talbo/Mendel90VAL/val/bom/bom.txt

Vitamins:
          E                                                         
          x                                                         
          t                                                         
          r                                                         
          u                                                         
          d                                                         
          e                                                         
          r                                                         
                                                                    
          c  E                          X                       Z   
          o  x                                                      
          n  t                 S        c                       l   
    E     n  r                 p        a                       i   
    l     e  u                 o     X  r           Y           m   
    e     c  d           P     o        r                       i   
    c  E  t  e           r     l     c  i           c           t   
 B  t  x  i  r     H  M  i           a  a  X  X     a  Y  Y        Z
 e  r  t  o        o  a  n     h  X  r  g        Y  r        Z  s   
 d  o  r  n  m  F  t  c  t     o     r  e  i  m     r  i  m     w  m
    n  u     o  r     h        l  a  i     d  o  a  i  d  o  a  i  o
 f  i  d  p  t  a  e  i  b  P  d  x  a  f  l  t  x  a  l  t  x  t  t
 a  c  e  c  o  m  n  n  e  s  e  i  g  a  e  o  i  g  e  o  i  c  o
 n  s  r  b  r  e  d  e  d  u  r  s  e  n  r  r  s  e  r  r  s  h  r
  |  |  |  |  | 2|  |  |  |  |  |  |  |  |  |  |  |  |  |  |  |  |  |  2 Acrylic sheet 158mm x 386mm x 5mm
  |  |  |  |  |  |  |  |  |  |  |  |  |  |  |  |  | 1|  |  |  |  |  |  1 Acrylic sheet 216mm x 216mm x 5mm
  |  |  |  |  | 1|  |  |  |  |  |  |  |  |  |  |  |  |  |  |  |  |  |  1 Acrylic sheet 471mm x 386mm x 5mm
  |  |  |  |  | 1|  |  |  |  |  |  |  |  |  |  |  |  |  |  |  |  |  |  1 Acrylic sheet 471mm x 419mm x 5mm
  |  |  |  |  |  |  |  |  | 1|  |  |  |  |  |  |  |  |  |  |  |  |  |  1 THS15 Aluminium clad resistor 10R
  |  |  |  |  |  |  |  |  | 1|  |  |  |  |  |  |  |  |  |  |  |  |  |  1 THS15 Aluminium clad resistor 4R7
  |  |  |  |  |  |  |  |  | 1|  |  |  |  |  |  |  |  |  |  |  |  |  |  1 PSU e.g. ALPINE500
  |  | 3|  |  |  |  |  |  |  | 4|  |  |  |  |  |  |  |  |  |  |  |  |  7 Ball bearing 608 8mm x 22mm x 7mm
  |  |  |  |  |  |  |  |  |  |  |  |  |  | 2|  |  |  | 2|  |  |  |  |  4 Ball bearing 624 4mm x 13mm x 5mm
  |  |  |  |  |  |  |  | 4|  |  |  |  |  |  |  |  |  |  |  |  |  |  |  4 19mm bulldog clip
  |  |  |  |  |  |  |  | 1|  |  |  |  |  |  |  |  |  |  |  |  |  |  |  1 PCB bed 214mm x 214mm
  |  |  |  |  |  |  |  |  |  |  |  |  |  |  |  | 1|  |  |  |  |  |  |  1 Belt T2 x 6mm x 662mm
  |  |  |  |  |  |  |  |  |  |  | 1|  |  |  |  |  |  |  |  |  |  |  |  1 Belt T2 x 6mm x 872mm
  |  |  |  |  |  |  |  | 4|  |  |  |  |  |  |  |  |  |  |  |  |  |  |  4 Corrugated cardboard 192mm x 216mm x 5mm
  |  |  |  |  |  |  |  | 4|  |  |  | 2|  |  |  |  |  |  |  |  |  |  |  6 M3 cap screw x 10mm
  | 4| 3|  |  |  |  |  |  |  |  |  |  |  |  | 6|  |14|  |  |  |  |  | 27 M3 cap screw x 16mm
  |  |  |  |  |  |  |  |  |  |  |  | 1|  |  | 2| 4| 2|  |  | 2|  |10| 21 M3 cap screw x 20mm
  |  |  |  |  |  |  |  |  |  |  |  | 2|  | 8| 8|  |  |  |  |  |  |  | 18 M3 cap screw x 25mm
  |  |  |  | 2|  |  |  |  |  |  |  |  |  |  | 1|  |  |  |  |  |  |  |  3 M3 cap screw x 45mm
  |  |  |  |  |34|  |  |  | 3| 2|  |  |  |  |  | 8|  | 1| 4| 4| 2| 4| 62 M4 cap screw x 16mm
 4|  |  |  |  |  |  |  |  |  |  |  |  |  |  |  |  |  |  |  |  |  |  |  4 M4 cap screw x 20mm
  |  |  |  |  |  |  |  |  |  |  |  |  | 4|  |  |  |  | 1|  |  |  |  |  5 M4 cap screw x 30mm
  |  |  |  |  |  |  |  |  |  |  |  |  |  | 1|  |  |  |  |  |  |  |  |  1 M4 cap screw x 45mm
  |  |  | 1|  |  |  |  |  |  |  |  |  |  |  |  |  |  |  |  |  |  |  |  1 15 way D PCB mount plug
  |  |  |  |  |  |  |  |  |  |  |  |  |  |  | 1|  |  |  |  |  |  |  |  1 15 way D IDC socket
  |  |  |  |  |  |  |  |  |  |  |  |  | 1|  |  |  |  |  |  |  |  |  |  1 Fan 60mm x 15mm
  |  |  |  |  |  |  |  |  |  | 1|  |  |  |  |  |  |  |  |  |  |  |  |  1 Foam sponge 20mm x 20mm x 20mm
  |  |  |  | 1|  |  |  |  |  |  |  |  |  |  | 1|  |  |  | 1|  |  |  |  3 M3 grub screw x 6mm
  |  |  |  |  |  |  |  | 1|  |  |  |  |  |  |  |  |  |  |  |  |  |  |  1 Glass sheet 214mm x 202mm x 2mm
  |  |  |  |  |  | 1|  |  |  |  |  |  |  |  |  |  |  |  |  |  |  |  |  1 JHead MK5 hot end
  |  |  |  |  |  |  |  | 4|  |  |  |  |  |  |  |  |  |  |  |  |  |  |  4 Hex male / female pillar M3 x 20mm
  |  | 3|  |  |  |  |  |  |  |  |  |  |  |  |  |  |  |  |  |  |  |  |  3 M3 hex screw x 10mm
  |  |  |  |  |  |  |  |  |  |  |  |  |  |  |  |  |  |  |  |  | 1|  |  1 M3 hex screw x 16mm
  |  | 2|  |  |  |  |  |  |  |  |  |  |  |  |  |  |  |  |  |  |  |  |  2 M4 hex screw x 20mm
  |  | 2|  |  |  |  |  |  |  |  |  |  |  |  |  |  |  |  |  |  |  |  |  2 M4 hex screw x 50mm
  |  | 1|  |  |  |  |  |  |  |  |  |  |  |  |  |  |  |  |  |  |  |  |  1 M8 hex screw x 60mm, hobbed at 25
  |  |  |  |  |  |  |  |  | 1|  |  |  |  |  |  |  |  |  |  |  |  |  |  1 IEC mains lead
  |  |  |  |  |  |  |  |  |  |  |  | 3|  | 2| 2|  | 3|  |  |  |  |  | 10 LM12UU linear bearing
  | 1|  |  |  |  |  |  |  |  |  |  |  |  |  |  |  |  |  |  |  |  |  |  1 Melzi electronics
  |  |  | 1|  |  |  |  |  |  |  |  |  |  |  |  |  |  |  |  |  |  |  |  1 2 way Molex KK header
  |  |  | 1|  |  |  |  |  |  |  |  |  |  |  |  |  |  |  |  |  |  |  |  1 3 way Molex KK header
  |  |  |  | 1|  |  |  |  |  |  |  |  |  |  | 1|  |  |  | 1|  |  | 2|  5 NEMA17 x 47mm stepper motor
  |  |  |  |  |  |  |  |  |  |  |  |  |  |  |  |  |  |  |  | 2|  |  |  2 Brass nut M6
  |  | 3|  | 3|  |  |  |  |  |  |  | 1|  |  |  |  |  |  |  |  |  |  |  7 Nut M3
  |  | 2|  |  |  |  |  |  |  |  |  |  |  |  |  |  |  |  |  |  |  |  |  2 Nut M4
  |  | 2|  |  |  |  |  |  |  |  |  |  |  |  |  |  |  |  |  |  |  |  |  2 Nut M8
  |  |  |  |  |  |  |  |  | 4|  |  |  |  |  |  |  |  |  |  |  |  |  |  4 Nyloc nut M2.5
  | 4|  |  |  |  |  |  |  |  |  |  | 4|  | 8|14| 4|16|  |  | 2| 1|10| 63 Nyloc nut M3
 4|  |  |  |  |36|  |  |  | 3| 2|  |  | 4| 1|  | 8|  | 2| 4| 4| 2| 4| 74 Nyloc nut M4
  |  |  |  |  |  |  |  |  |  |  |  |  |  |  | 2|  |  |  |  |  |  |  |  2 Nitrile O-ring 2.5mm x 1.6mm
  |  |  | 1|  |  |  |  |  |  |  |  |  |  |  |  |  |  |  |  |  |  |  |  1 Extruder connection PCB
  |  |  |  |  |  |  |  |  |  | 1|  |  |  |  |  |  |  |  |  |  |  |  |  1 PLA sample 3mm ~50m
  |  |  |  |  |  |  |  |  |  |  |  |  |  |  | 1|  |  |  |  |  |  |  |  1 Polypropylene strip 396mm x 18mm x 0.5mm
  |  |  |  |  |  |  |  |  |  |  |  |  |  |  | 1|  |  |  |  |  |  |  |  1 Polypropylene strip 494mm x 25mm x 0.5mm
  |  |  |  |  |  |  |  | 1|  |  |  |  |  |  |  |  |  |  |  |  |  |  |  1 Polypropylene strip 271mm x 33mm x 0.5mm
  |  |  |  |  |  |  |  |  | 4|  |  |  |  |  |  |  |  |  |  |  |  |  |  4 M2.5 pan screw x 12mm
  |  |  |  |  |  |  |  |  |  |  |  |  |  |  | 2|  |  |  | 4|  |  | 8| 14 M3 pan screw x 8mm
  |  |  |  |  |  |  |  |  | 2|  |  |  |  |  |  |  |  |  |  |  |  |  |  2 6-32 pan screw x 9.5mm
  |  |  |  | 2|  |  |  |  |  |  |  |  |  |  | 4| 2|  |  |  | 2| 2|  | 12 No2 pan wood screw x 13mm
  |  |  |  |  |  |  |  |  |  |  |  |  |  |  | 1|  |  |  | 1|  |  |  |  2 GT2 pulley 20 teeth
  |  |  |  |  |  |  |  |  |  |  |  |  |  |  | 1|  |  |  |  |  |  |  |  1 Ribbon cable 20 way 1260mm
  |  |  |  |  |  |  |  | 1|  |  |  |  |  |  |  |  |  |  |  |  |  |  |  1 Ribbon cable 26 way 381mm
  |  |  |  |  |  |  |  |  |  |  |  |  |  |  |  | 1|  |  |  |  |  |  |  1 Smooth rod 12mm x 276mm
  |  |  |  |  |  |  |  |  |  |  |  |  |  |  |  |  |  |  |  | 2|  |  |  2 Smooth rod 12mm x 338mm
  |  |  |  |  |  |  |  |  |  |  | 2|  |  |  |  |  |  |  |  |  |  |  |  2 Smooth rod 12mm x 387mm
  |  |  |  |  |  |  |  |  |  |  |  |  |  |  |  | 1|  |  |  |  |  |  |  1 Smooth rod 12mm x 417mm
  |  | 1|  |  |  |  |  |  |  |  |  |  |  |  |  |  |  |  |  |  |  |  |  1 Smooth rod 8mm x 22mm
  | 1|  |  |  |  |  |  |  |  |  |  |  |  |  |  |  |  |  |  |  |  |  |  1 Micro SD card
  | 1|  |  |  |  |  |  |  |  |  |  |  |  |  |  |  |  |  |  |  |  |  |  1 Micro SD to USB adapter
  |  |  |  |  |  |  |  |  |  |  |  |  |  |  | 1| 1|  |  |  | 1| 1|  |  4 Microswitch
  |  | 2|  |  |  |  |  |  |  |  |  |  |  |  |  |  |  |  |  |  |  |  |  2 Spring 7mm OD, 1mm gauge x 10mm long
  |  |  |  |  | 2|  |  |  |  |  |  |  |  |  |  |  |  |  |  |  |  |  |  2 AL square tube 12.7 x 12.7 x 1.63 x 400mm
  |  |  |  |  |  | 1|  |  |  |  |  |  |  |  |  |  |  |  |  |  |  |  |  1 110mm x 25mm self amalgamating silicone tape
  |  |  |  |  |  |  |  |  |  |  |  |  |  |  |  |  |  |  |  | 2|  |  |  2 Threaded rod M6 x 298mm
  |  |  |  |  |  |  |  |  | 1|  |  |  |  |  |  |  |  |  |  |  |  |  |  1 Heatshrink sleeving ID 10mm x 15mm
  |  |  |  |  |  | 2|  |  |  |  |  |  |  |  |  |  |  |  |  |  |  |  |  2 PTFE sleeving OD 1.2mm ID 0.71mm x 62mm
  |  |  |  |  |  | 2|  | 2|  |  |  |  |  |  |  |  |  |  |  |  |  |  |  4 Heatshrink sleeving ID 1.6mm x 15mm
  |  |  |  |  |  | 2|  |  |  |  |  |  |  |  |  |  |  |  |  |  |  |  |  2 PTFE sleeving OD 2.6mm ID 2mm x 45mm
  | 2|  |  |  |  |  |  | 2| 3|  |  |  |  |  | 4|  |  |  |  |  |  |  | 11 Heatshrink sleeving ID 2.4mm x 15mm
  |  |  |  |  |  |  |  |  | 5|  |  |  |  |  |  |  |  |  |  |  |  |  |  5 Heatshrink sleeving ID 3.2mm x 15mm
  |  |  |  |  |  |  |  |  |  | 1|  |  |  |  |  |  |  |  |  |  |  |  |  1 PTFE tubing OD 4.6mm ID 3.84mm x 750mm
  |  |  |  |  |  |  |  |  | 2|  |  |  |  |  |  |  |  |  |  |  |  |  |  2 Heatshrink sleeving ID 6.4mm x 15mm
  |  |  |  |  |  |  |  | 2|  |  |  |  |  |  |  |  |  |  |  |  |  |  |  2 Heatshrink sleeving ID 6.4mm x 30mm
  |  |  |  |  |  | 1|  |  |  |  |  |  |  |  |  |  |  |  |  |  |  |  |  1 Heatshrink sleeving ID 6.4mm x 60mm
  |  |  |  |  |  |  |  |  |  |  |  |  |  |  |  |  |  |  |  |  |  | 2|  2 Neoprene tubing OD 8mm ID 5mm x 16mm
  |  |  | 2|  |  |  |  |  |  |  |  |  |  |  |  |  |  |  |  |  |  |  |  2 4 way terminal block
  |  |  |  |  |  |  |  | 1|  |  |  |  |  |  |  |  |  |  |  |  |  |  |  1 Epcos B57861S104F40 100K 1% thermistor
  | 1|  |  |  |  |  |  |  |  |  |  |  |  |  |  |  |  |  |  |  |  |  |  1 USB A to Mini B lead
  |  |  |  | 2|  |  |  |  | 4|  |  |  |  |  | 4| 2|  |  |  | 2| 2|  | 16 Washer M2.5 x 5.9mm x 0.5mm
  | 8| 3|  | 2|  |  |  | 4|  |  |  | 4|  | 8|21| 4|16|  | 4| 2| 1|18| 95 Washer M3 x 7mm x 0.5mm
 4|  | 7|  |  |38|  |  |  | 5| 2|  |  | 4| 2|  | 8|  | 5| 4| 4| 2| 4| 89 Washer M4 x 9mm x 0.8mm
  |  |  |  |  |  |  |  |  |  |  |  |  |  | 2|  |  |  | 2|  |  |  |  |  4 Washer M5 x 20mm x 1.4mm
  |  |  |  |  |  |  |  |  |  |12|  |  |  |  |  |  |  |  |  |  |  |  | 12 Washer M8 x 17mm x 1.6mm
  |  |  |  |  |  |  |  |  |  | 4|  |  |  |  |  |  |  |  |  |  |  |  |  4 Washer M8 x 30mm x 1.5mm
  |  |  |  |  |  |  |  |  |  |  | 2|  |  |  |  |  |  |  |  |  |  |  |  2 Wingnut M4
  |  |  |  |  |  | 2|  |  |  |  |  |  |  |  |  |  |  |  |  |  |  |  |  2 Red PTFE wire 16/0.2 length 170mm
  |  |  |  |  |  |  |  |  |  |  |  |  |  |  |  |  |  |  |  |  | 2|  |  2 Rubber washer M3 x 10mm x 1.5mm
  |  |  |  |  |  |  |  | 1|  |  |  |  |  |  |  |  |  |  |  |  |  |  |  1 Black wire 32/0.2 length 635mm
  |  |  |  |  |  |  |  | 1|  |  |  |  |  |  |  |  |  |  |  |  |  |  |  1 Red wire 32/0.2 length 620mm
  |  | 6|  |  |  |  |  |  |  |  |  |  |  |  | 2|  |  |  | 4|  |  | 8| 20 Star washer M3 x 0.5mm
  |  |  |  |  |  |  |  |  | 2|  |  |  |  |  |  |  |  |  |  |  |  |  |  2 Star washer M4 x 0.8mm
  |  | 1|  |  |  |  |  |  |  |  |  |  |  |  |  |  |  |  |  |  |  |  |  1 Star washer M8 x 1.6mm
  |  |  |  |  |10| 1|  |  | 2|  |  |  |  |  |  |  |  |  |  |  |  |  | 13 Ziptie 100mm min length
  |  |  |  |  |  |  |  |  |  |  |  | 3|  |  |  |  | 3|  |  |  |  |  |  6 Ziptie 111mm min length

Printed:
  |  |  |  |  |  |  |  |  | 1|  |  |  |  |  |  |  |  |  |  |  |  |  |  1 atx_long_bracket.stl
  |  |  |  |  |  |  |  |  | 1|  |  |  |  |  |  |  |  |  |  |  |  |  |  1 atx_short_bracket.stl
  |  |  |  | 1|  |  |  |  |  |  |  |  |  |  |  |  |  |  |  |  |  |  |  1 d_motor_bracket.stl
  |  |  |  | 1|  |  |  |  |  |  |  |  |  |  |  |  |  |  |  |  |  |  |  1 d_motor_bracket_lid.stl
  |  |  |  |  |  |  |  |  |  |  |  |  |  |  | 1|  |  |  |  |  |  |  |  1 d_shell.stl
  |  |  |  |  |  |  |  |  |  |  |  |  |  |  | 1|  |  |  |  |  |  |  |  1 d_shell_lid.stl
  |  |  |  |  |  |  |  |  |  | 1|  |  |  |  |  |  |  |  |  |  |  |  |  1 dust_filter.stl
 1|  |  |  |  |  |  |  |  |  |  |  |  |  |  |  |  |  |  |  |  |  |  |  1 fan_guard.stl
  |  |  |  |  | 8|  |  |  |  |  |  |  |  |  |  |  |  |  |  |  |  |  |  8 fixing_block.stl
  | 4|  |  |  |  |  |  |  |  |  |  |  |  |  |  |  |  |  |  |  |  |  |  4 pcb_spacer.stl
  |  |  |  |  | 2|  |  |  |  |  |  |  |  |  |  |  |  |  |  |  |  |  |  2 rear_fixing_block.stl
  |  |  |  |  |  |  |  |  |  |  |  |  |  |  | 1|  |  |  |  |  |  |  |  1 ribbon_clamp_14_33.stl
  |  |  |  |  |  |  |  |  |  |  |  |  |  |  | 1|  |  |  |  |  |  |  |  1 ribbon_clamp_14_33NB.stl
  |  |  |  |  |  |  |  |  |  |  |  |  |  |  | 1|  |  |  |  |  |  |  |  1 ribbon_clamp_20_33.stl
  |  |  |  |  | 1|  |  |  |  |  |  |  |  |  |  |  |  |  |  |  |  |  |  1 ribbon_clamp_20_44N.stl
  |  |  |  |  |  |  |  |  |  |  |  |  |  |  |  |  | 1|  |  |  |  |  |  1 ribbon_clamp_26_33.stl
  |  |  |  |  |  |  |  |  |  |  |  |  |  |  |  |  | 1|  |  |  |  |  |  1 ribbon_clamp_26_33N.stl
  |  |  |  |  | 1|  |  |  |  |  |  |  |  |  |  |  |  |  |  |  |  |  |  1 ribbon_clamp_26_44N.stl
  |  |  |  |  |  |  |  |  |  | 2|  |  |  |  |  |  |  |  |  |  |  |  |  2 spool_bracket_female.stl
  |  |  |  |  |  |  |  |  |  | 2|  |  |  |  |  |  |  |  |  |  |  |  |  2 spool_bracket_male.stl
  |  |  |  |  | 4|  |  |  |  |  |  |  |  |  |  |  |  |  |  |  |  |  |  4 tube_cap.stl
  |  | 1|  |  |  |  |  |  |  |  |  |  |  |  |  |  |  |  |  |  |  |  |  1 wades_big_gear.stl
  |  | 1|  |  |  |  |  |  |  |  |  |  |  |  |  |  |  |  |  |  |  |  |  1 wades_block.stl
  |  | 1|  |  |  |  |  |  |  |  |  |  |  |  |  |  |  |  |  |  |  |  |  1 wades_gear_spacer.stl
  |  | 1|  |  |  |  |  |  |  |  |  |  |  |  |  |  |  |  |  |  |  |  |  1 wades_idler_block.stl
  |  |  |  | 1|  |  |  |  |  |  |  |  |  |  |  |  |  |  |  |  |  |  |  1 wades_small_gear.stl
  |  |  |  |  |  |  |  |  |  |  |  | 1|  |  |  |  |  |  |  |  |  |  |  1 x_belt_clamp.stl
  |  |  |  |  |  |  |  |  |  |  |  | 1|  |  |  |  |  |  |  |  |  |  |  1 x_belt_grip.stl
  |  |  |  |  |  |  |  |  |  |  |  | 1|  |  |  |  |  |  |  |  |  |  |  1 x_belt_tensioner.stl
  |  |  |  |  |  |  |  |  |  |  |  | 1|  |  |  |  |  |  |  |  |  |  |  1 x_carriage.stl
  |  |  |  |  |  |  |  |  |  |  |  |  | 1|  |  |  |  |  |  |  |  |  |  1 x_carriage_fan_bracket.stl
  |  |  |  |  |  |  |  |  |  |  |  |  | 1|  |  |  |  |  |  |  |  |  |  1 x_carriage_fan_duct.stl
  |  |  |  |  |  |  |  |  |  |  |  |  |  | 2| 2|  |  |  |  |  |  |  |  4 x_end_clamp.stl
  |  |  |  |  |  |  |  |  |  |  |  |  |  | 1|  |  |  |  |  |  |  |  |  1 x_idler_bracket.stl
  |  |  |  |  |  |  |  |  |  |  |  |  |  |  | 1|  |  |  |  |  |  |  |  1 x_motor_bracket.stl
  |  |  |  |  |  |  |  |  |  |  |  |  |  |  | 1|  |  |  |  |  |  |  |  1 x_motor_ribbon_bracket.stl
  |  |  |  |  |  |  |  |  |  |  |  |  |  |  |  | 3|  |  |  |  |  |  |  3 y_bar_clamp.stl
  |  |  |  |  |  |  |  |  |  |  |  |  |  |  |  | 1|  |  |  |  |  |  |  1 y_bar_clamp_switch.stl
  |  |  |  |  |  |  |  |  |  |  |  |  |  |  |  |  | 3|  |  |  |  |  |  3 y_bearing_mount.stl
  |  |  |  |  |  |  |  |  |  |  |  |  |  |  |  |  | 1|  |  |  |  |  |  1 y_belt_anchor.stl
  |  |  |  |  |  |  |  |  |  |  |  |  |  |  |  |  | 1|  |  |  |  |  |  1 y_belt_anchor_toothed.stl
  |  |  |  |  |  |  |  |  |  |  |  |  |  |  |  |  | 1|  |  |  |  |  |  1 y_belt_clip.stl
  |  |  |  |  |  |  |  |  |  |  |  |  |  |  |  |  | 1|  |  |  |  |  |  1 y_belt_clip_toothed.stl
  |  |  |  |  |  |  |  |  |  |  |  |  |  |  |  |  |  | 1|  |  |  |  |  1 y_idler_bracket.stl
  |  |  |  |  |  |  |  |  |  |  |  |  |  |  |  |  |  |  | 1|  |  |  |  1 y_motor_bracket.stl
  |  |  |  |  |  |  |  |  |  |  |  |  |  |  |  |  |  |  |  | 2|  |  |  2 z_bar_clamp.stl
  |  |  |  |  |  |  |  |  |  |  |  |  |  |  |  |  |  |  |  |  |  | 4|  4 z_coupling.stl
  |  |  |  |  |  |  |  |  |  |  |  |  |  |  |  |  |  |  |  |  | 1|  |  1 z_limit_switch_bracket.stl
  |  |  |  |  |  |  |  |  |  |  |  |  |  |  |  |  |  |  |  |  |  | 1|  1 z_motor_bracket_lhs.stl
  |  |  |  |  |  |  |  |  |  |  |  |  |  |  |  |  |  |  |  |  |  | 1|  1 z_motor_bracket_rhs.stl
  |  |  |  |  |  |  |  |  |  |  |  |  |  |  |  |  |  |  |  | 2|  |  |  2 z_screw_pointer.stl

Sub-assemblies:
  1 bed_fan_assembly
  1 electronics_assembly
  1 extruder_assembly
  1 extruder_connection_pcb_assembly
  1 extruder_motor_assembly
  1 frame_assembly
  1 hot_end_assembly
  1 machine_assembly
  1 print_bed_assembly
  1 psu_assembly
  1 spool_holder_assembly
  1 x_axis_assembly
  1 x_carriage_assembly
  1 x_carriage_fan_assembly
  1 x_idler_assembly
  1 x_motor_assembly
  1 y_axis_assembly
  1 y_carriage_assembly
  1 y_idler_assembly
  1 y_motor_assembly
  1 z_axis_assembly
  1 z_limit_switch_assembly
  2 z_motor_assemblies
