talbo/Mendel90VAL/val/sheets/frame_gantry.dxf

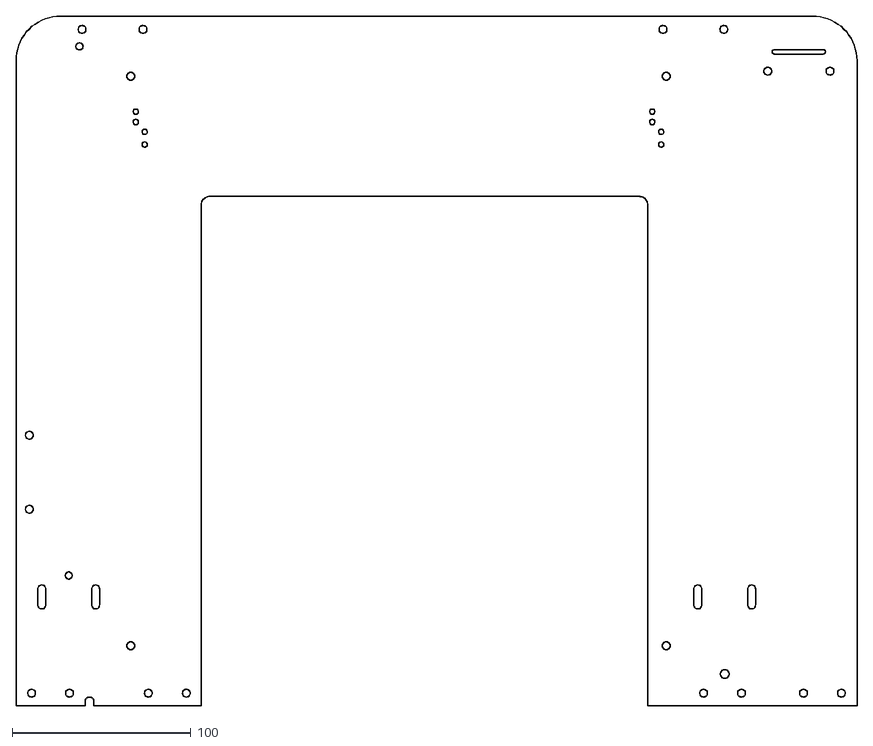
[picture p1: CAD file, 2014-06-18]
val/sheets/frame_gantry.dxf
470.5 x 386.0
