talbo/Mendel90VAL/val/stls/printed/x_motor_ribbon_bracket.stl

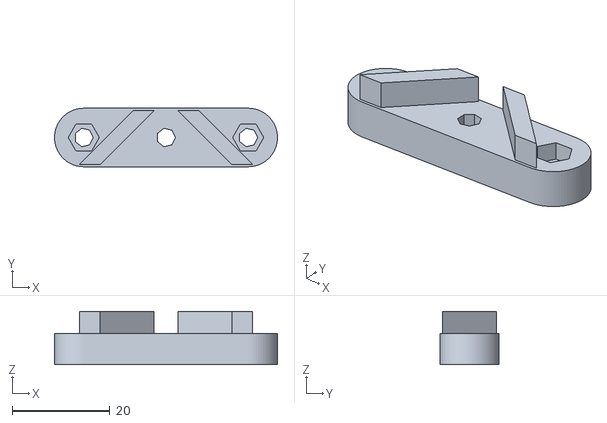
[picture p2: CAD file, 2014-06-18]
val/stls/printed/x_motor_ribbon_bracket.stl
45.7 x 12.0 x 10.9
