talbo/Mendel90VAL/val/stls/z_limit_switch_bracket.stl

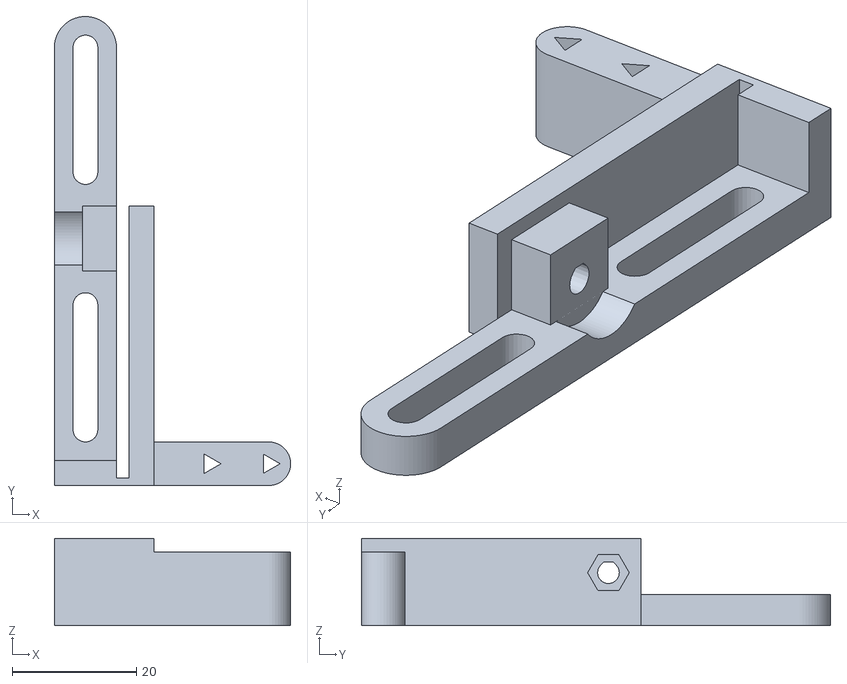
[picture p3: CAD file, 2014-06-18]
val/stls/z_limit_switch_bracket.stl
38.0 x 75.4 x 14.0
