talbo/Mendel90VAL/val/sheets/y_carriage.dxf

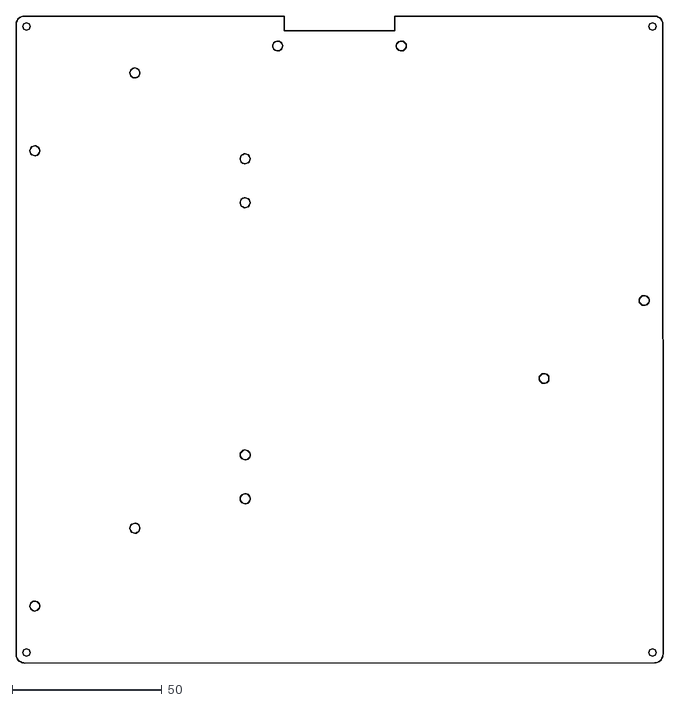
[picture p4: CAD file, 2014-06-18]
val/sheets/y_carriage.dxf
216.0 x 216.0
