talbo/Mendel90VAL/val/stls/printed/fan_guard.stl

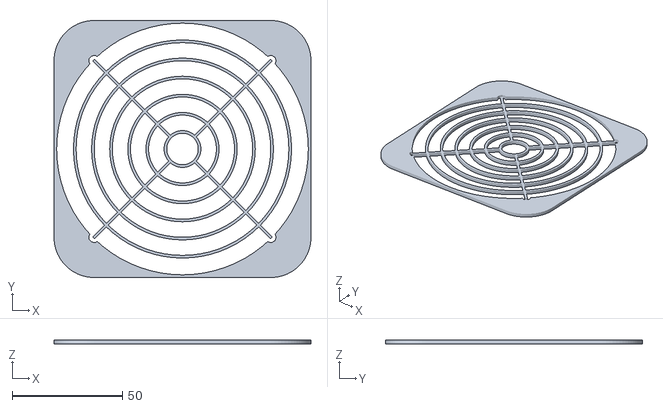
[picture p5: CAD file, 2014-06-18]
val/stls/printed/fan_guard.stl
116.4 x 116.4 x 2.00
