talbo/Mendel90VAL/val/stls/y_motor_bracket.stl

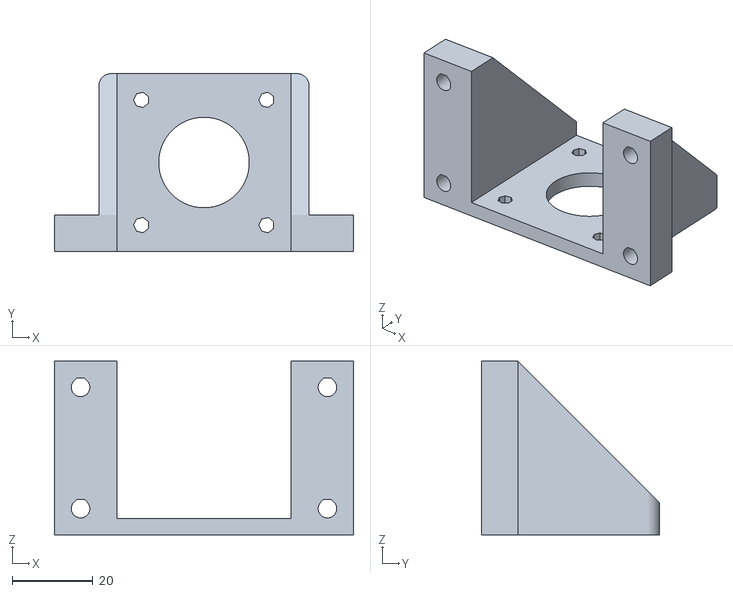
[picture p6: CAD file, 2014-06-18]
val/stls/y_motor_bracket.stl
74.0 x 44.0 x 43.0
