talbo/Mendel90VAL/val/sheets/frame_stays.dxf

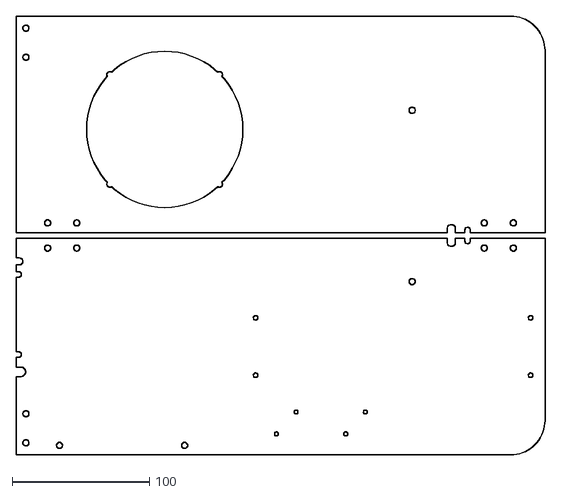
[picture p7: CAD file, 2014-06-18]
val/sheets/frame_stays.dxf
386.0 x 320.0
