talbo/Mendel90VAL/val/stls/printed/small_bits.stl

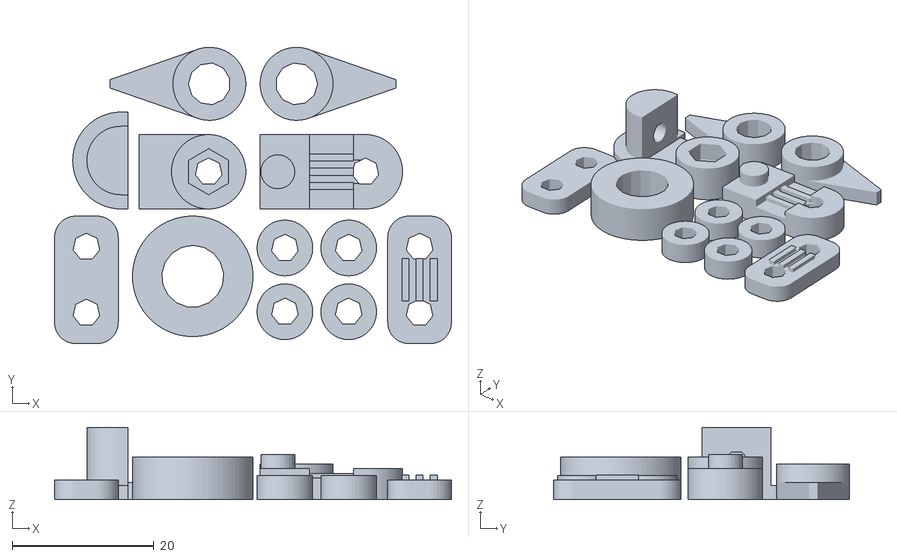
[picture p8: CAD file, 2014-06-18]
val/stls/printed/small_bits.stl
56.0 x 41.8 x 10.2
