talbo/Mendel90VAL/val/stls/z_motor_bracket_rhs.stl

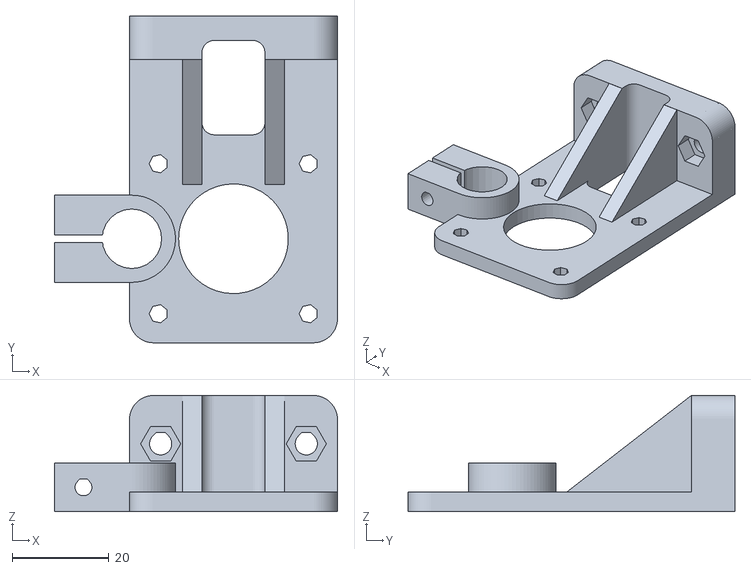
[picture p9: CAD file, 2014-06-18]
val/stls/z_motor_bracket_rhs.stl
58.5 x 67.5 x 24.0
