talbo/Mendel90VAL/val/sheets/frame_gantry_and_y_carriage.dxf

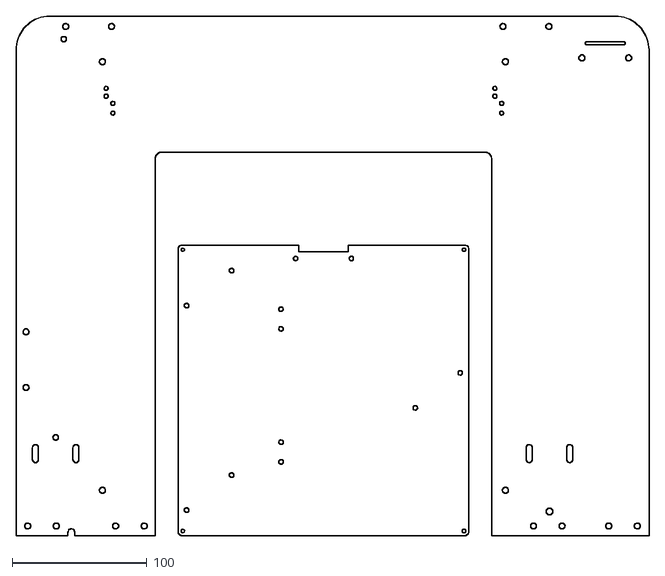
[picture p10: CAD file, 2014-06-18]
val/sheets/frame_gantry_and_y_carriage.dxf
470.5 x 386.0
