talbo/Mendel90VAL/val/stls/printed/z_motor_brackets.stl

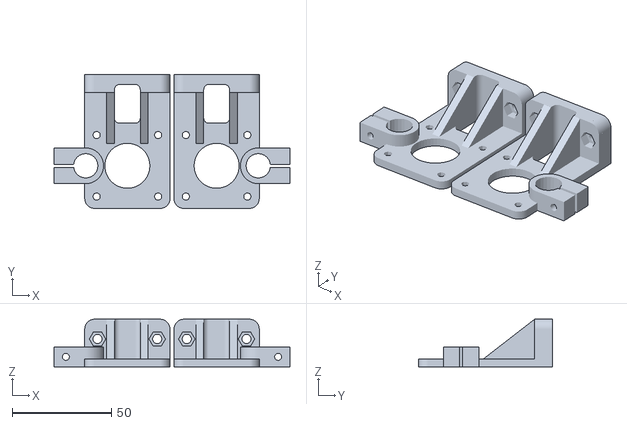
[picture p11: CAD file, 2014-06-18]
val/stls/printed/z_motor_brackets.stl
119.0 x 67.5 x 24.0
