talbo/Mendel90VAL/val/stls/tube_cap.stl

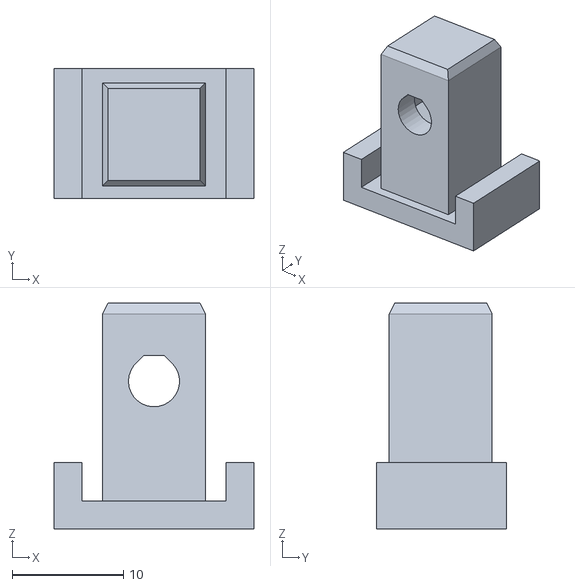
[picture p12: CAD file, 2014-06-18]
val/stls/tube_cap.stl
18.0 x 11.7 x 20.4
