talbo/Mendel90VAL/val/sheets/frame_base.dxf

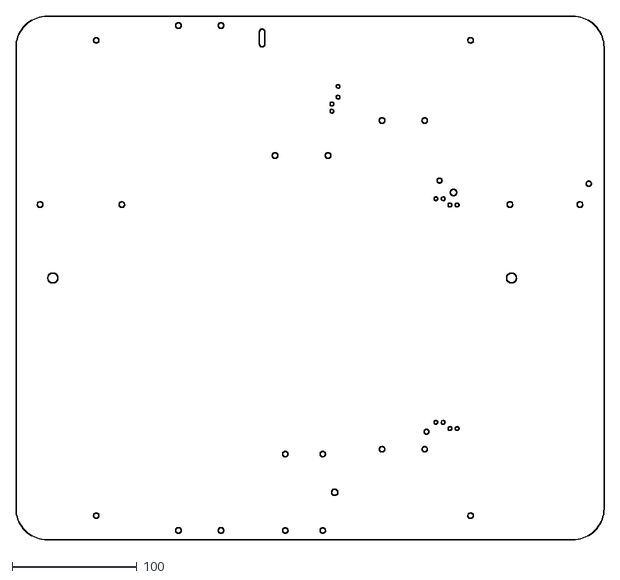
[picture p13: CAD file, 2014-06-18]
val/sheets/frame_base.dxf
470.5 x 419.0
