talbo/Mendel90VAL/val/stls/printed/wades_big_gear.stl

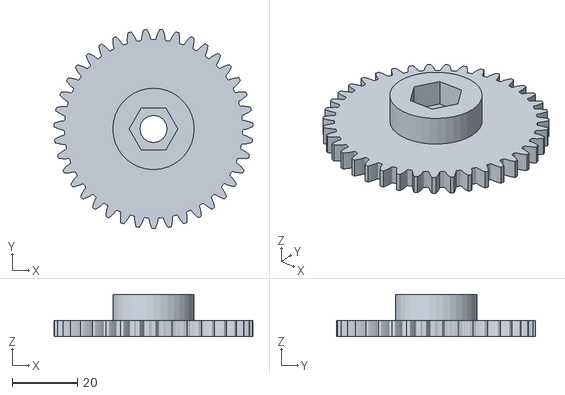
[picture p14: CAD file, 2014-06-18]
val/stls/printed/wades_big_gear.stl
61.1 x 61.1 x 13.0
