talbo/Mendel90VAL/val/stls/x_belt_grip.stl

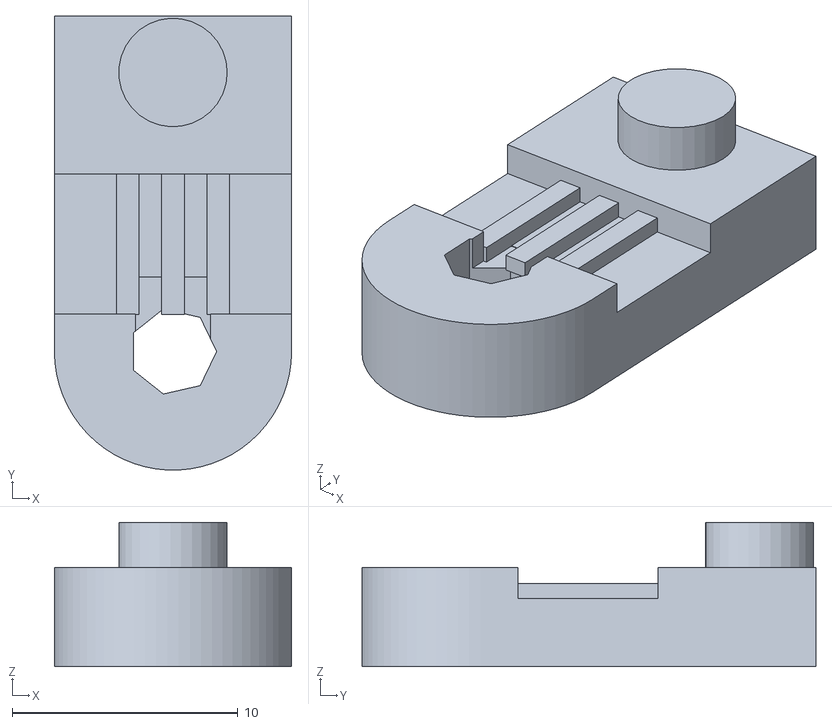
[picture p15: CAD file, 2014-06-18]
val/stls/x_belt_grip.stl
10.5 x 20.1 x 6.39
