talbo/Mendel90VAL/val/sheets/y_heatshield.dxf

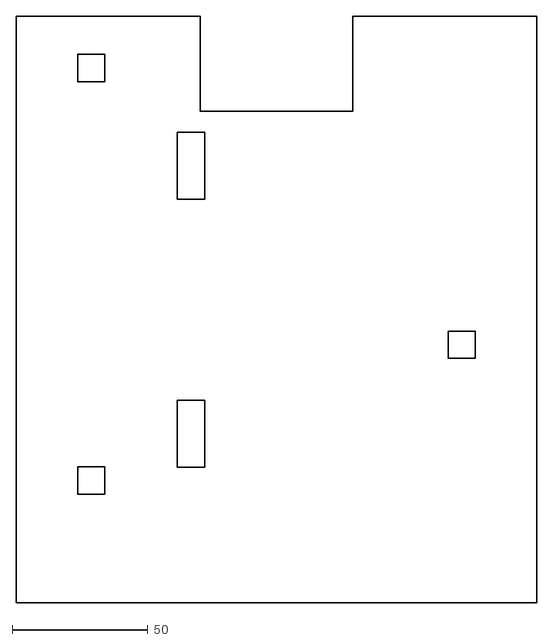
[picture p16: CAD file, 2014-06-18]
val/sheets/y_heatshield.dxf
192.0 x 216.0
