talbo/Mendel90VAL/val/stls/atx_short_bracket.stl

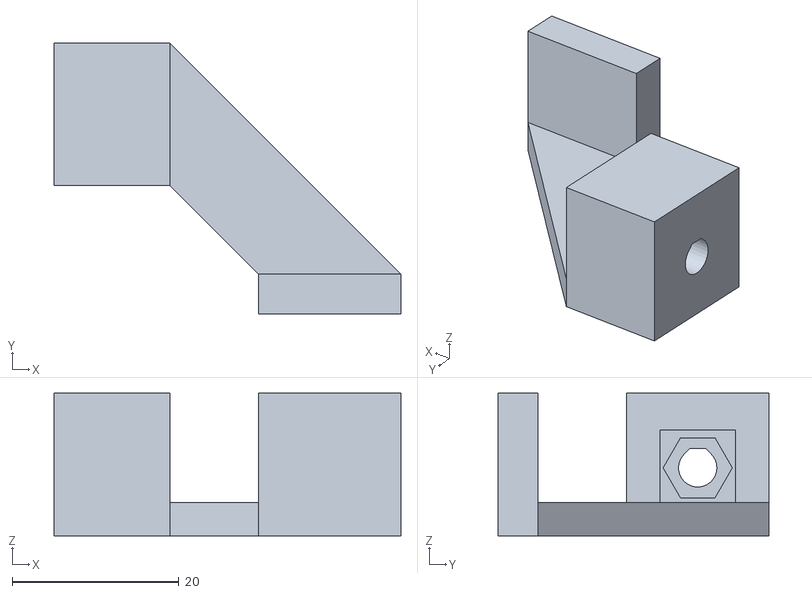
[picture p17: CAD file, 2014-06-18]
val/stls/atx_short_bracket.stl
41.6 x 32.5 x 17.1
