talbo/Mendel90VAL/val/sheets/frame_right.dxf

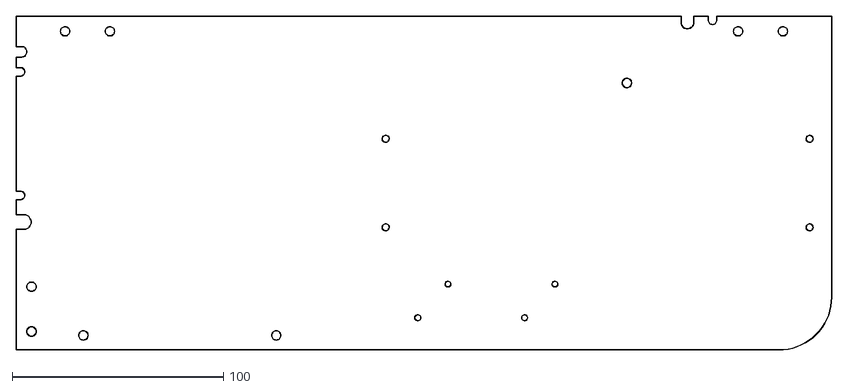
[picture p18: CAD file, 2014-06-18]
val/sheets/frame_right.dxf
386.0 x 158.0
