talbo/Mendel90VAL/val/stls/printed/x_carriage_parts.stl

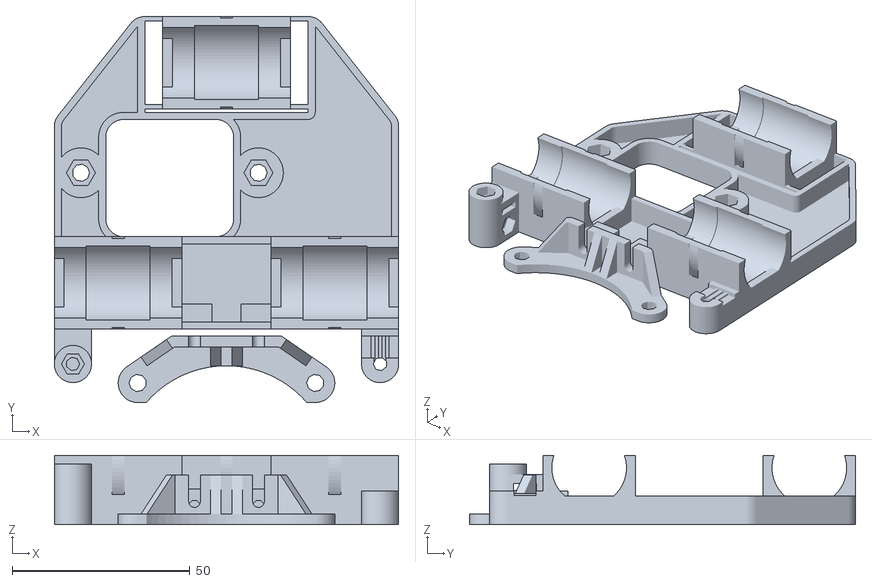
[picture p19: CAD file, 2014-06-18]
val/stls/printed/x_carriage_parts.stl
97.0 x 108.7 x 19.5
