talbo/Mendel90VAL/val/sheets/frame_left.dxf

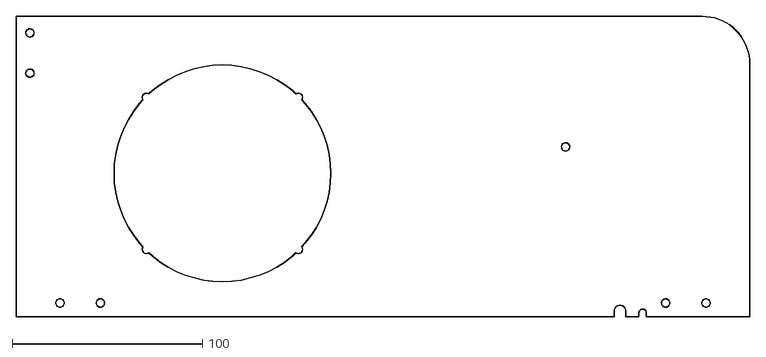
[picture p20: CAD file, 2014-06-18]
val/sheets/frame_left.dxf
386.0 x 158.0
