talbo/Mendel90VAL/val/stls/printed/x_end_clamp.stl

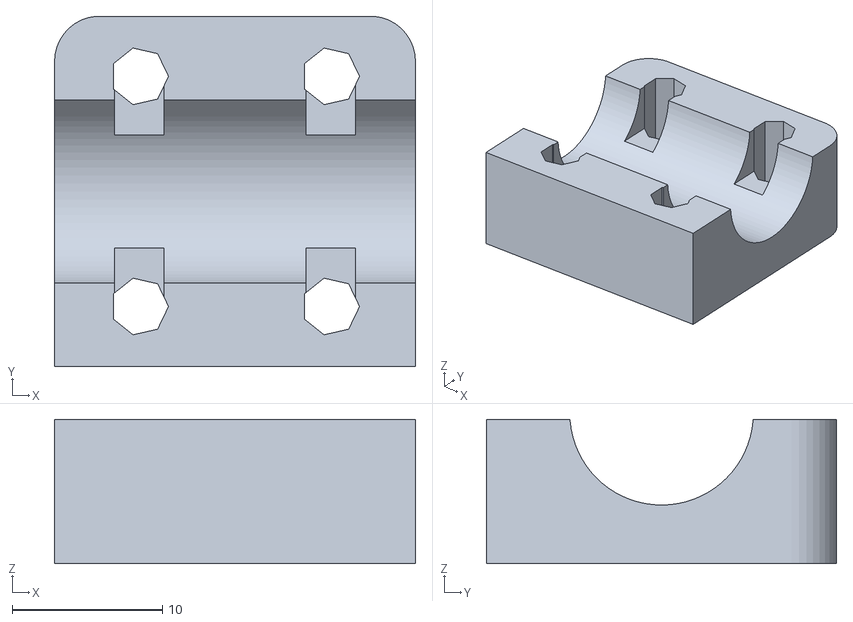
[picture p21: CAD file, 2014-06-18]
val/stls/printed/x_end_clamp.stl
24.0 x 23.3 x 9.60
