talbo/Mendel90VAL/val/stls/printed/y_idler_bracket.stl

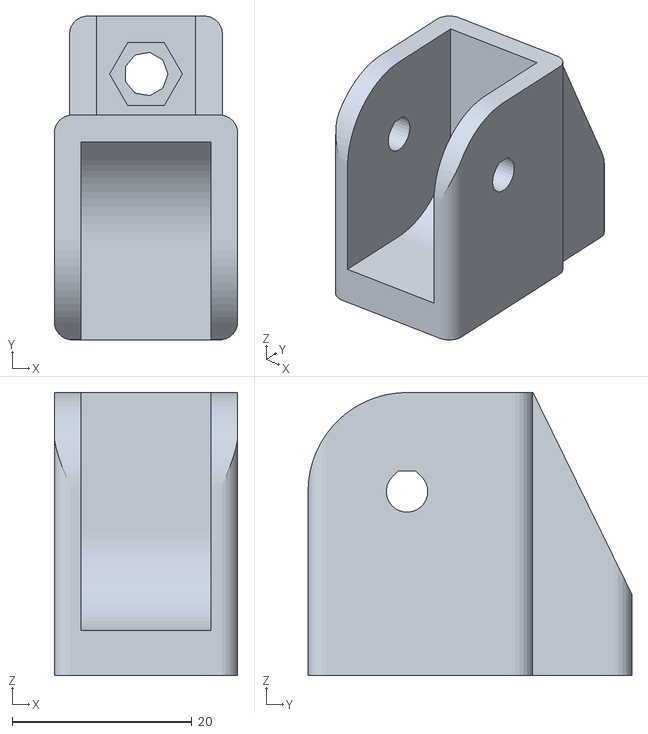
[picture p22: CAD file, 2014-06-18]
val/stls/printed/y_idler_bracket.stl
20.4 x 36.0 x 31.5
