talbo/Mendel90VAL/val/stls/spool_bracket_female.stl

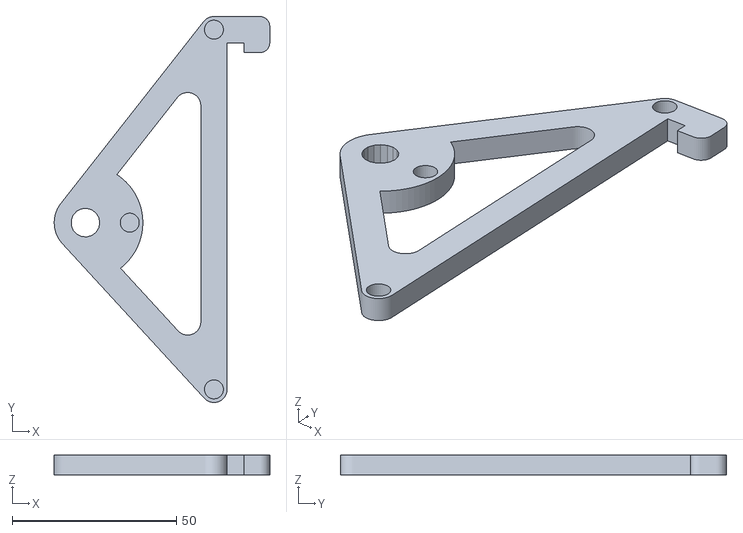
[picture p23: CAD file, 2014-06-18]
val/stls/spool_bracket_female.stl
65.6 x 117.5 x 6.00
