talbo/Mendel90VAL/val/stls/d_motor_bracket.stl

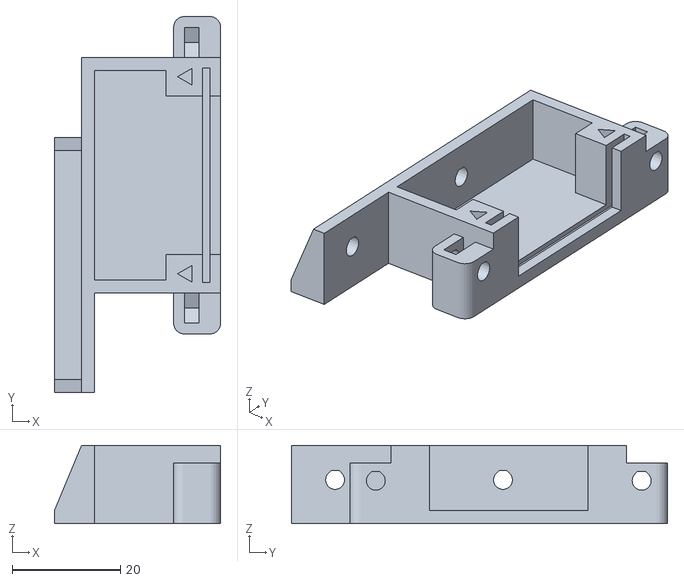
[picture p24: CAD file, 2014-06-18]
val/stls/d_motor_bracket.stl
30.7 x 69.4 x 14.4
