talbo/Mendel90VAL/val/stls/printed/d_motor_brackets.stl

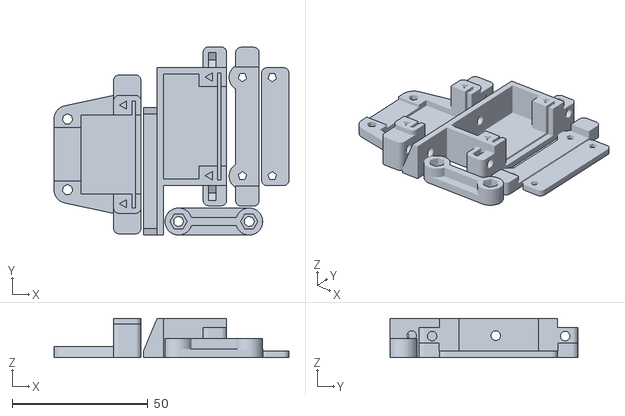
[picture p25: CAD file, 2014-06-18]
val/stls/printed/d_motor_brackets.stl
86.7 x 69.4 x 14.4
