talbo/Mendel90VAL/val/stls/printed/bar_clamps.stl

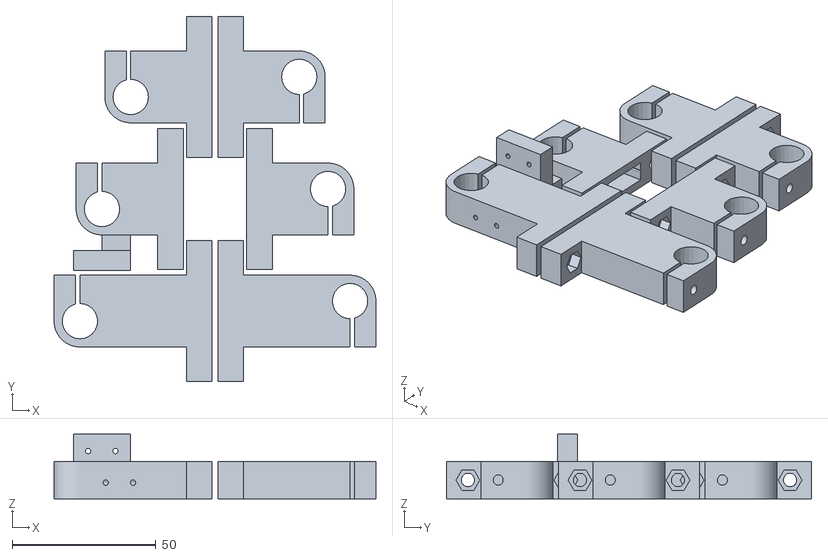
[picture p26: CAD file, 2014-06-18]
val/stls/printed/bar_clamps.stl
112.0 x 127.0 x 22.5
