talbo/Mendel90VAL/val/stls/spool_bracket_male.stl

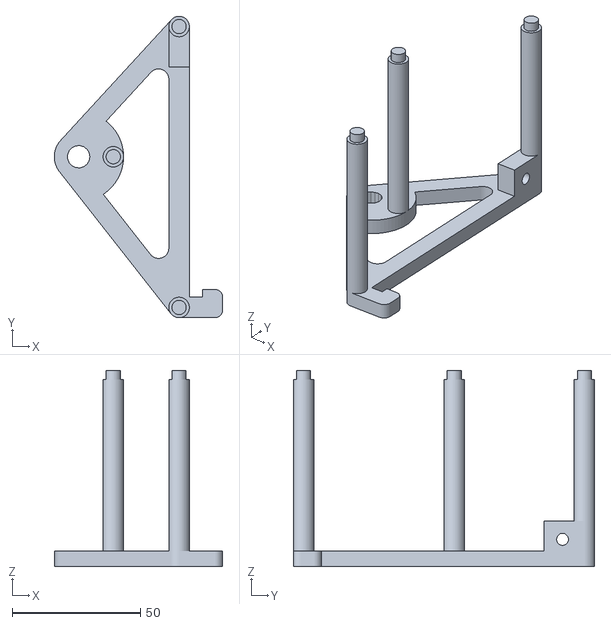
[picture p27: CAD file, 2014-06-18]
val/stls/spool_bracket_male.stl
65.6 x 117.5 x 76.4
