talbo/Mendel90VAL/val/stls/printed/y_bearing_mounts.stl

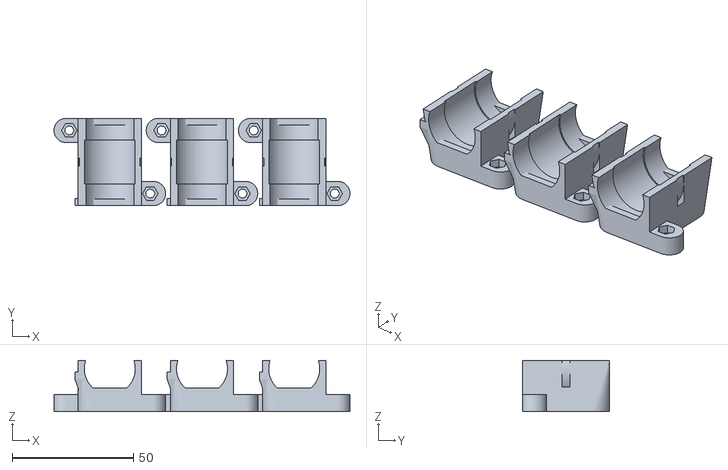
[picture p28: CAD file, 2014-06-18]
val/stls/printed/y_bearing_mounts.stl
122.0 x 36.0 x 21.2
