talbo/Mendel90VAL/val/stls/printed/cable_clips.stl

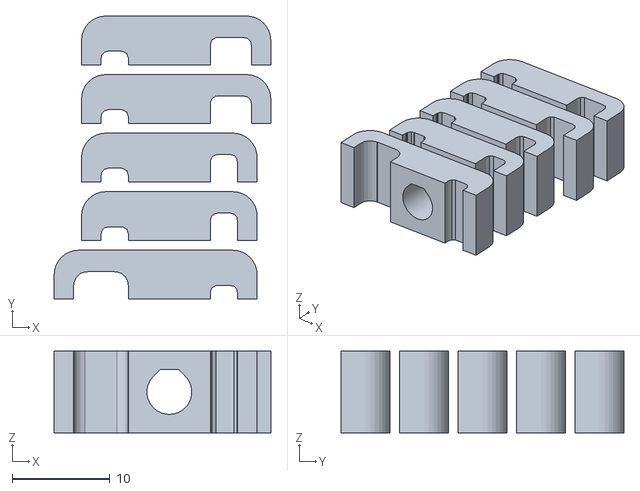
[picture p29: CAD file, 2014-06-18]
val/stls/printed/cable_clips.stl
22.2 x 29.0 x 8.40
