talbo/Mendel90VAL/val/stls/y_belt_clip.stl

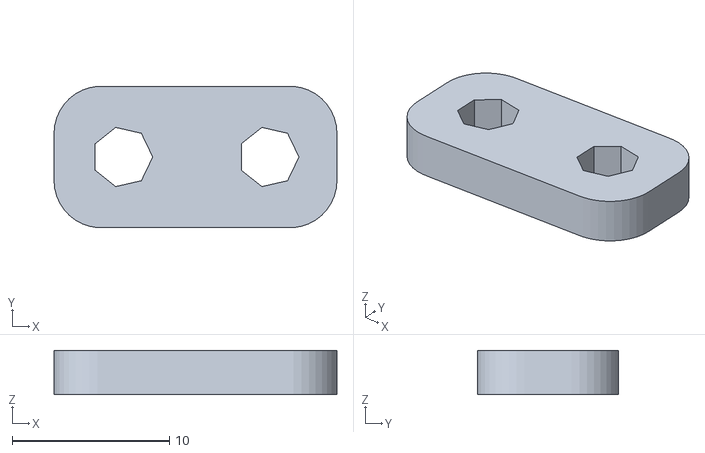
[picture p30: CAD file, 2014-06-18]
val/stls/y_belt_clip.stl
18.0 x 9.00 x 2.80
