talbo/Mendel90VAL/val/stls/dust_filter.stl

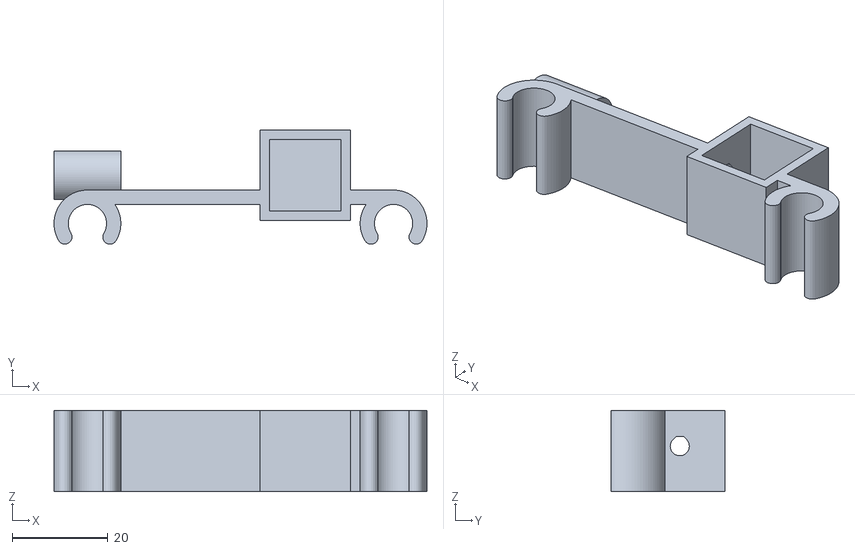
[picture p31: CAD file, 2014-06-18]
val/stls/dust_filter.stl
78.1 x 23.9 x 17.0
