talbo/Mendel90VAL/val/stls/printed/x_idler_bracket.stl

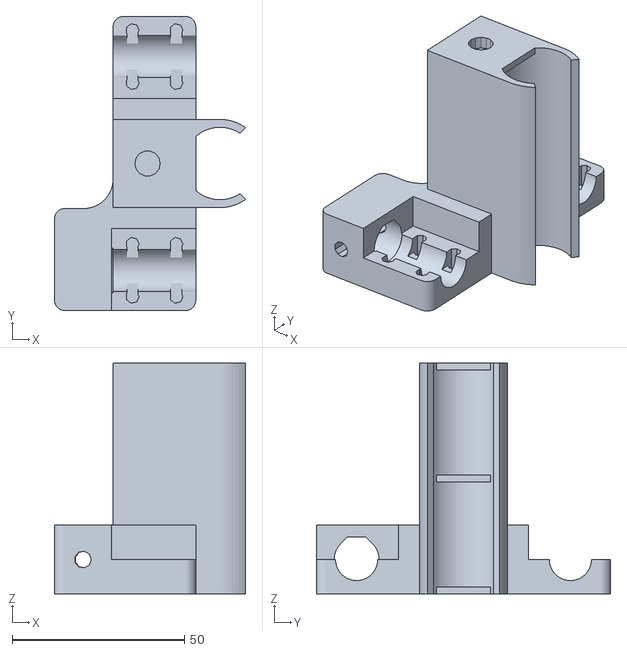
[picture p32: CAD file, 2014-06-18]
val/stls/printed/x_idler_bracket.stl
55.4 x 85.3 x 67.0
