talbo/Mendel90VAL/val/stls/printed/x_motor_bracket.stl

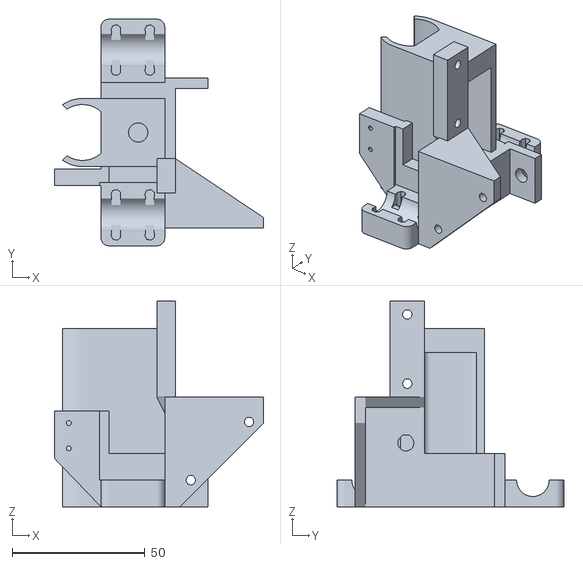
[picture p33: CAD file, 2014-06-18]
val/stls/printed/x_motor_bracket.stl
78.6 x 85.3 x 77.4
