talbo/Mendel90VAL/val/stls/wades_small_gear.stl

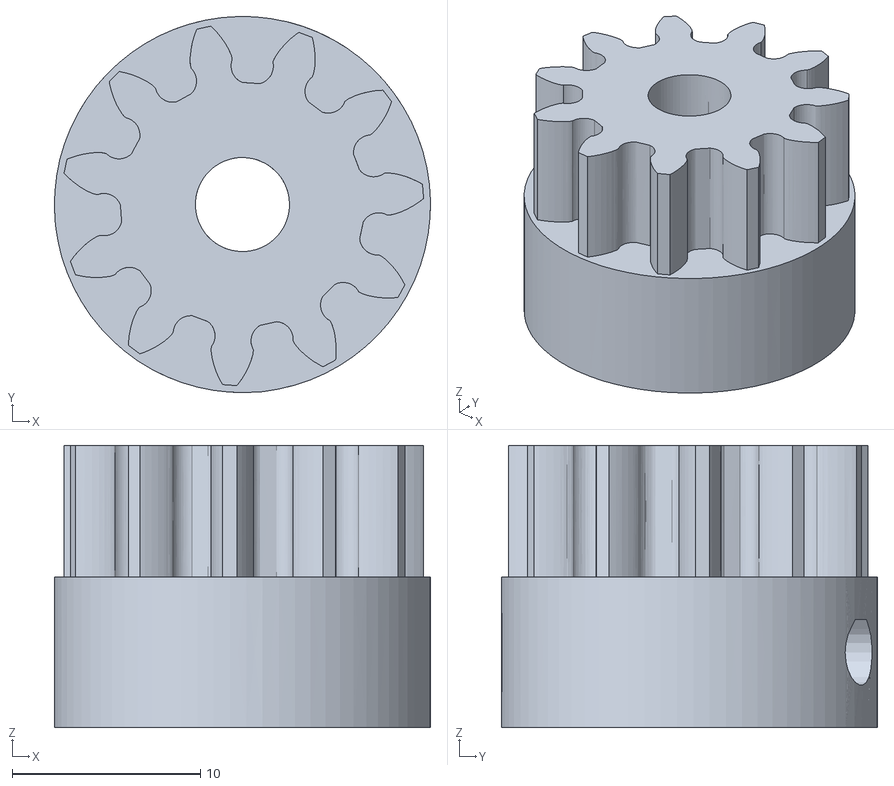
[picture p34: CAD file, 2014-06-18]
val/stls/wades_small_gear.stl
20.0 x 20.0 x 15.0
