talbo/Mendel90VAL/val/stls/printed/wades_extruder.stl

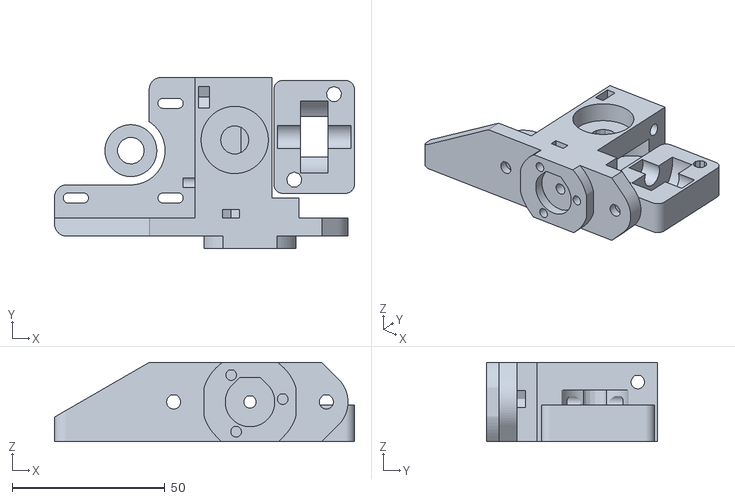
[picture p35: CAD file, 2014-06-18]
val/stls/printed/wades_extruder.stl
98.2 x 56.1 x 26.0
