talbo/Mendel90VAL/val/stls/rear_fixing_block.stl

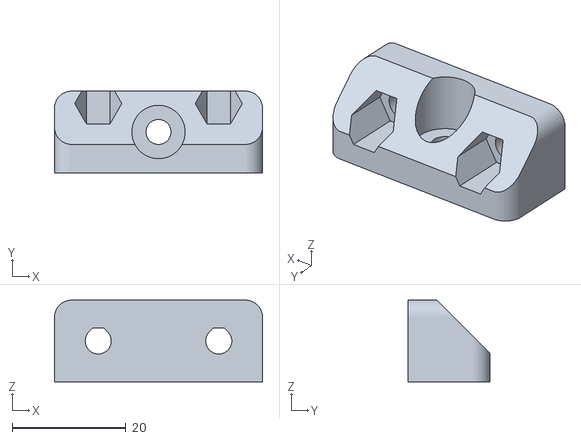
[picture p36: CAD file, 2014-06-18]
val/stls/rear_fixing_block.stl
36.6 x 14.4 x 14.4
