talbo/Mendel90VAL/val/stls/printed/spool_holder_brackets.stl

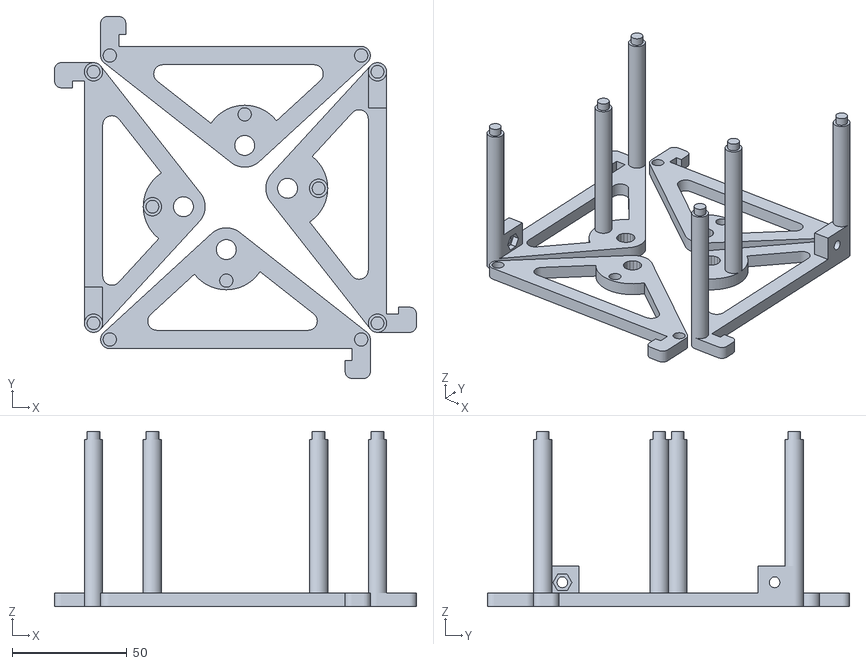
[picture p37: CAD file, 2014-06-18]
val/stls/printed/spool_holder_brackets.stl
157.6 x 157.6 x 76.4
