talbo/Mendel90VAL/val/stls/ribbon_clamp_26_33.stl

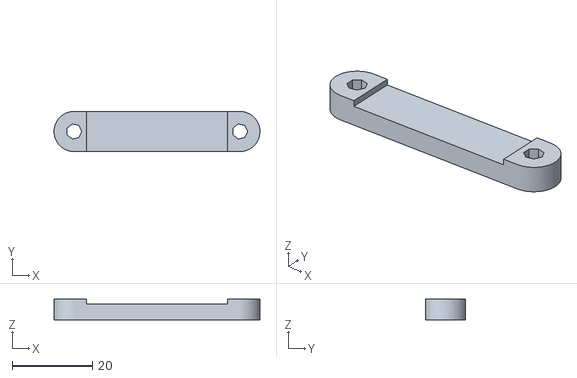
[picture p38: CAD file, 2014-06-18]
val/stls/ribbon_clamp_26_33.stl
51.3 x 10.00 x 5.20
