talbo/Mendel90VAL/val/stls/printed/z_coupling.stl

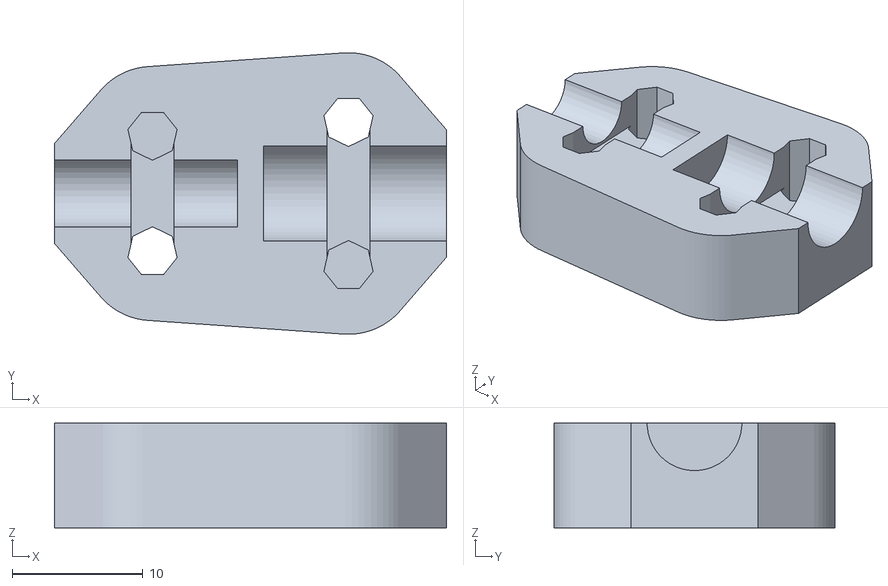
[picture p39: CAD file, 2014-06-18]
val/stls/printed/z_coupling.stl
30.0 x 21.5 x 8.00
