talbo/Mendel90VAL/val/stls/y_belt_anchor.stl

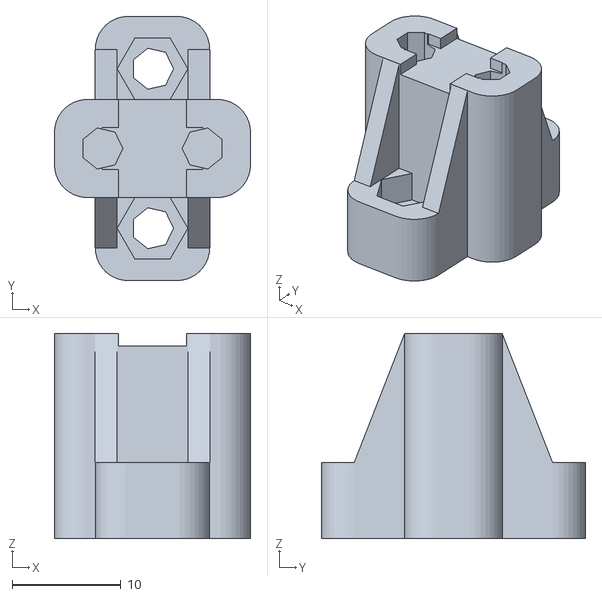
[picture p40: CAD file, 2014-06-18]
val/stls/y_belt_anchor.stl
18.0 x 24.3 x 18.9
