talbo/Mendel90VAL/val/stls/printed/x_carriage_fan_duct.stl

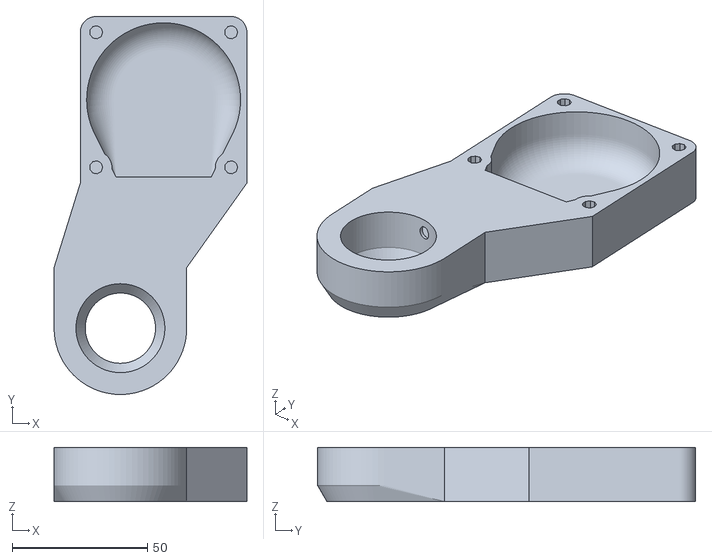
[picture p41: CAD file, 2014-06-18]
val/stls/printed/x_carriage_fan_duct.stl
71.4 x 140.0 x 20.0
