talbo/Mendel90VAL/val/stls/ribbon_clamp_26_33N.stl

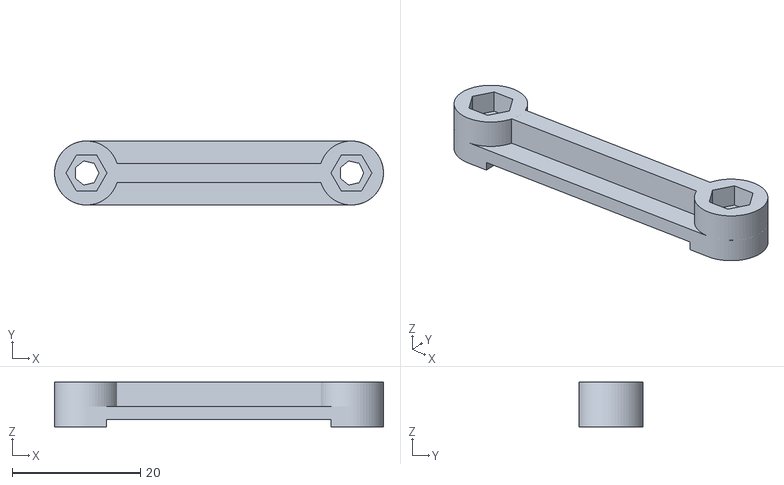
[picture p42: CAD file, 2014-06-18]
val/stls/ribbon_clamp_26_33N.stl
51.3 x 10.00 x 7.01
