talbo/Mendel90VAL/val/stls/printed/cal.stl

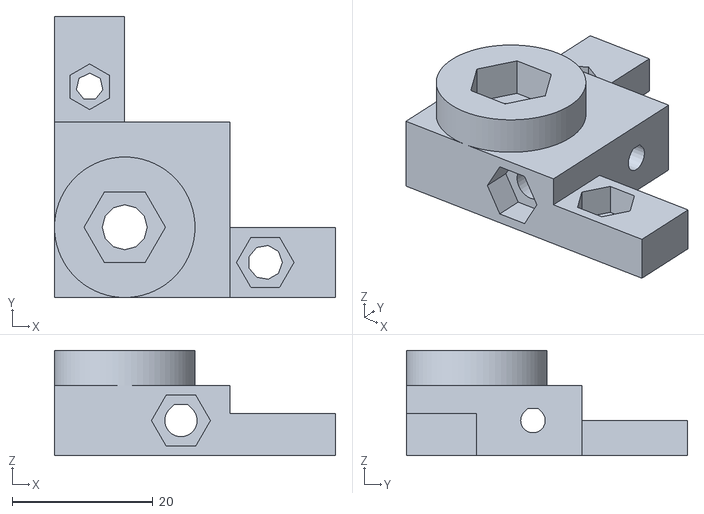
[picture p43: CAD file, 2014-06-18]
val/stls/printed/cal.stl
40.0 x 40.0 x 15.0
