talbo/Mendel90VAL/val/stls/y_bar_clamp_switch.stl

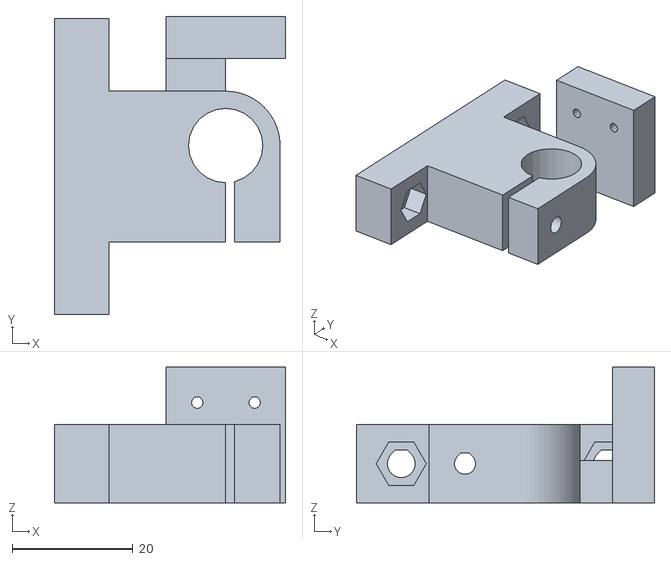
[picture p44: CAD file, 2014-06-18]
val/stls/y_bar_clamp_switch.stl
38.2 x 49.4 x 22.5
