talbo/Mendel90VAL/val/stls/y_belt_clip_toothed.stl

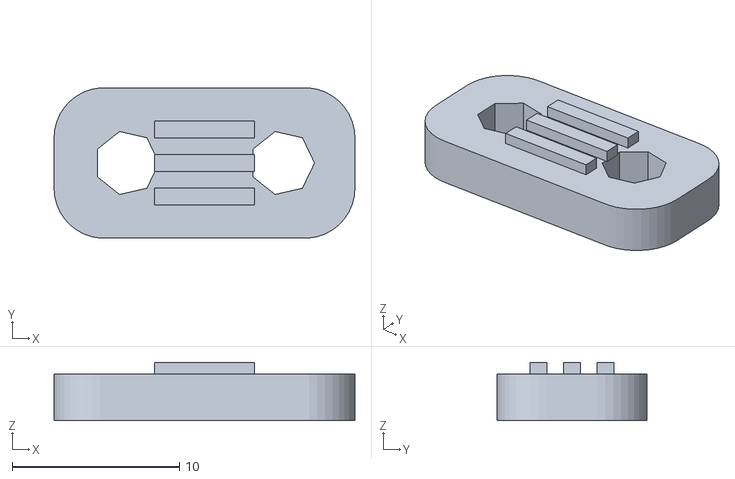
[picture p45: CAD file, 2014-06-18]
val/stls/y_belt_clip_toothed.stl
18.0 x 9.00 x 3.48
