talbo/Mendel90VAL/val/stls/printed/atx_brackets.stl

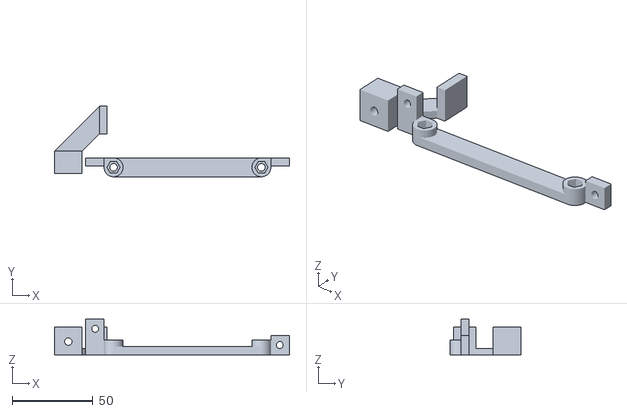
[picture p46: CAD file, 2014-06-18]
val/stls/printed/atx_brackets.stl
145.1 x 43.6 x 22.0
