talbo/Mendel90VAL/val/stls/ribbon_clamp_14_33.stl

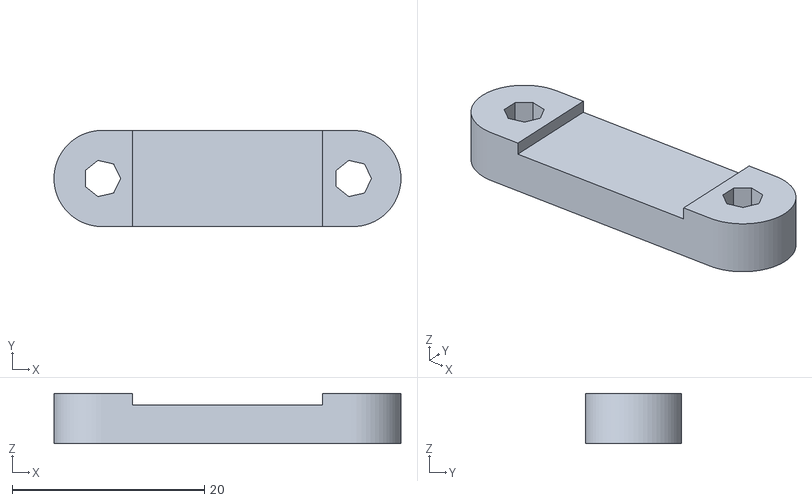
[picture p47: CAD file, 2014-06-18]
val/stls/ribbon_clamp_14_33.stl
36.1 x 10.00 x 5.20
