talbo/Mendel90VAL/val/stls/printed/y_belt_anchors.stl

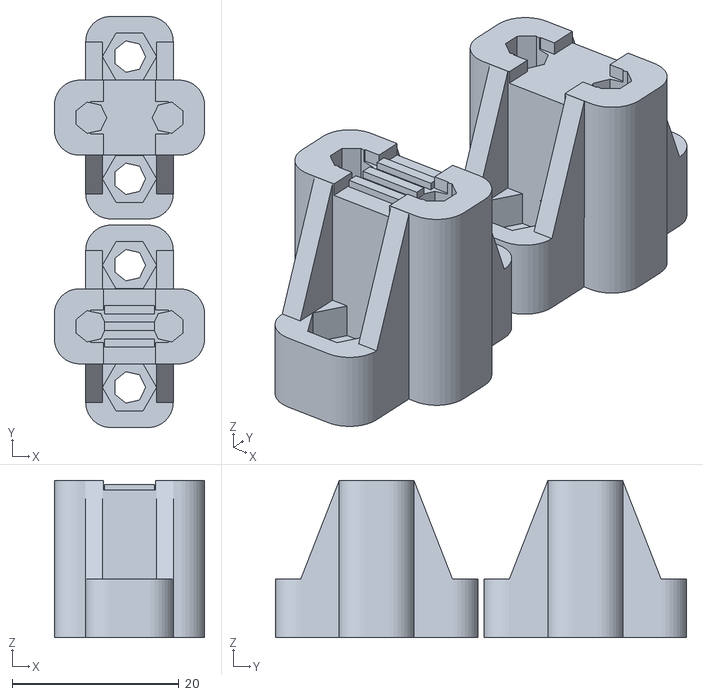
[picture p48: CAD file, 2014-06-18]
val/stls/printed/y_belt_anchors.stl
18.0 x 49.3 x 18.9
