talbo/Mendel90VAL/val/stls/y_bearing_mount.stl

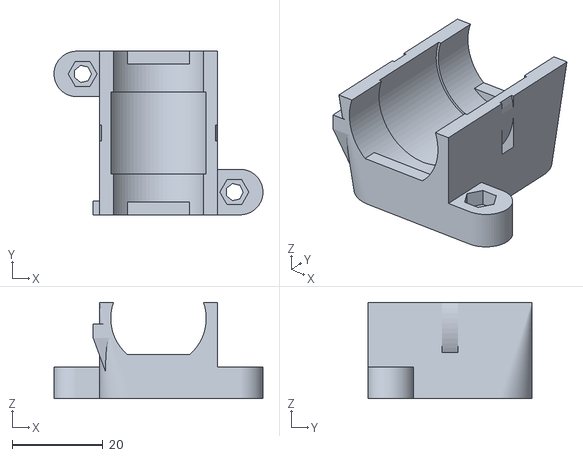
[picture p49: CAD file, 2014-06-18]
val/stls/y_bearing_mount.stl
46.0 x 36.0 x 21.2
