talbo/Mendel90VAL/val/stls/d_shell.stl

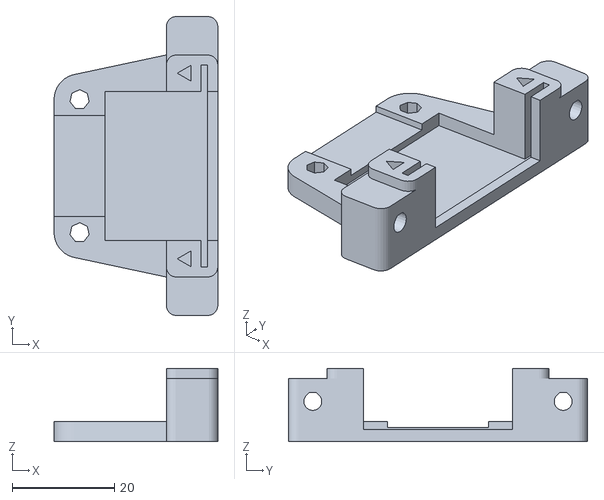
[picture p50: CAD file, 2014-06-18]
val/stls/d_shell.stl
32.1 x 58.6 x 14.4
