talbo/Mendel90VAL/val/stls/printed/ribbon_clamps.stl

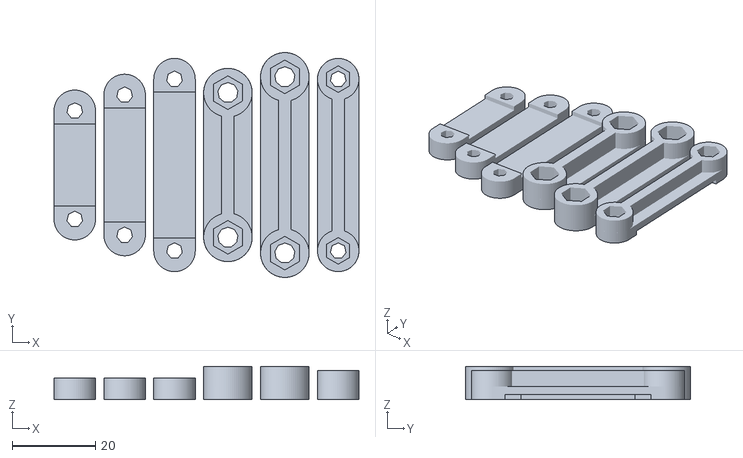
[picture p51: CAD file, 2014-06-18]
val/stls/printed/ribbon_clamps.stl
73.4 x 54.1 x 8.01
