talbo/Mendel90VAL/val/stls/printed/fixing_blocks.stl

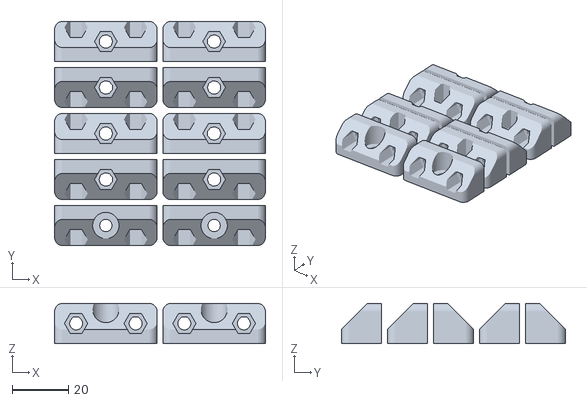
[picture p52: CAD file, 2014-06-18]
val/stls/printed/fixing_blocks.stl
75.2 x 80.0 x 14.4
