talbo/Mendel90VAL/val/stls/pcb_spacer.stl

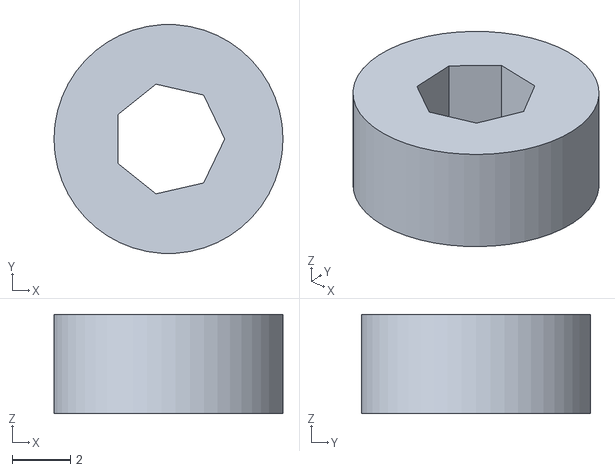
[picture p53: CAD file, 2014-06-18]
val/stls/pcb_spacer.stl
7.86 x 7.85 x 3.40
