talbo/Mendel90VAL/val/stls/ribbon_clamp_20_33.stl

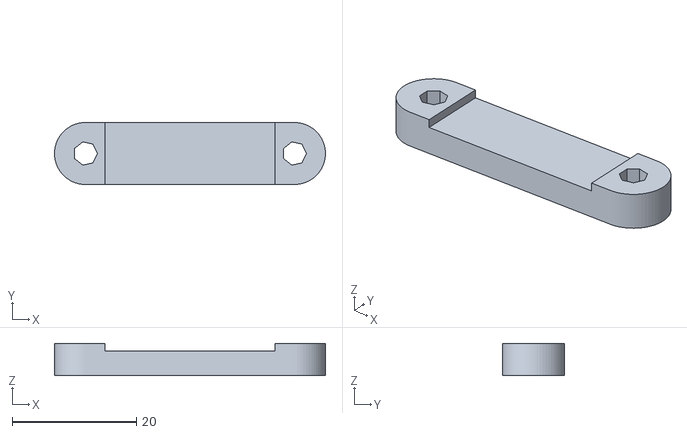
[picture p54: CAD file, 2014-06-18]
val/stls/ribbon_clamp_20_33.stl
43.7 x 10.00 x 5.20
