talbo/Mendel90VAL/val/stls/x_belt_tensioner.stl

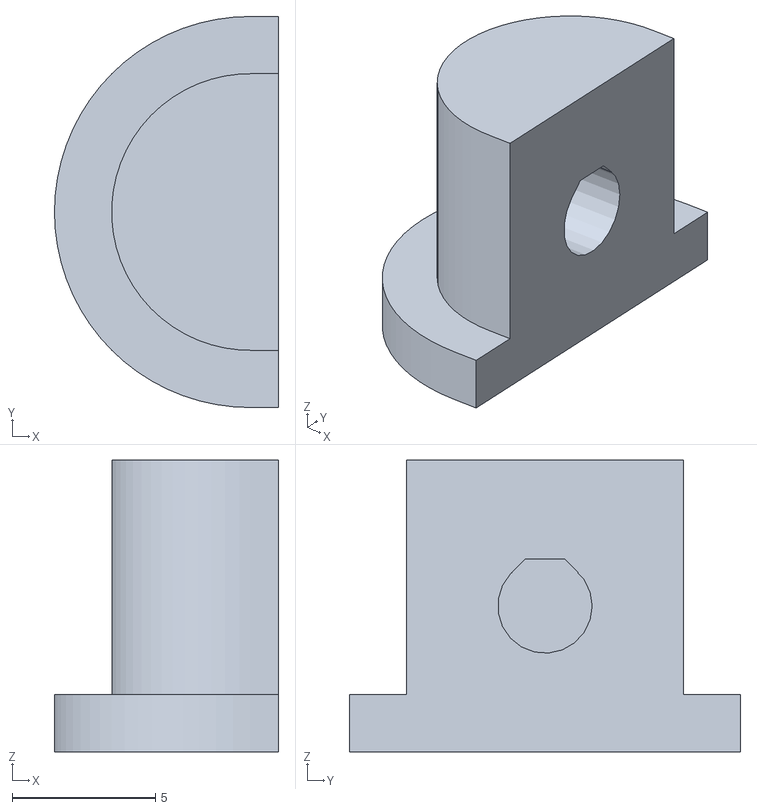
[picture p55: CAD file, 2014-06-18]
val/stls/x_belt_tensioner.stl
7.83 x 13.7 x 10.2
