talbo/Mendel90VAL/val/stls/ribbon_clamp_20_44N.stl

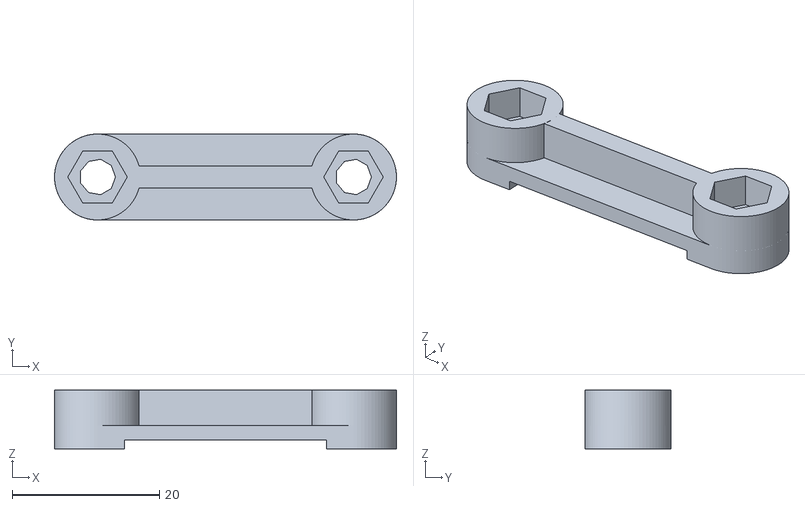
[picture p56: CAD file, 2014-06-18]
val/stls/ribbon_clamp_20_44N.stl
46.5 x 11.7 x 8.01
