talbo/Mendel90VAL/val/stls/y_bar_clamp.stl

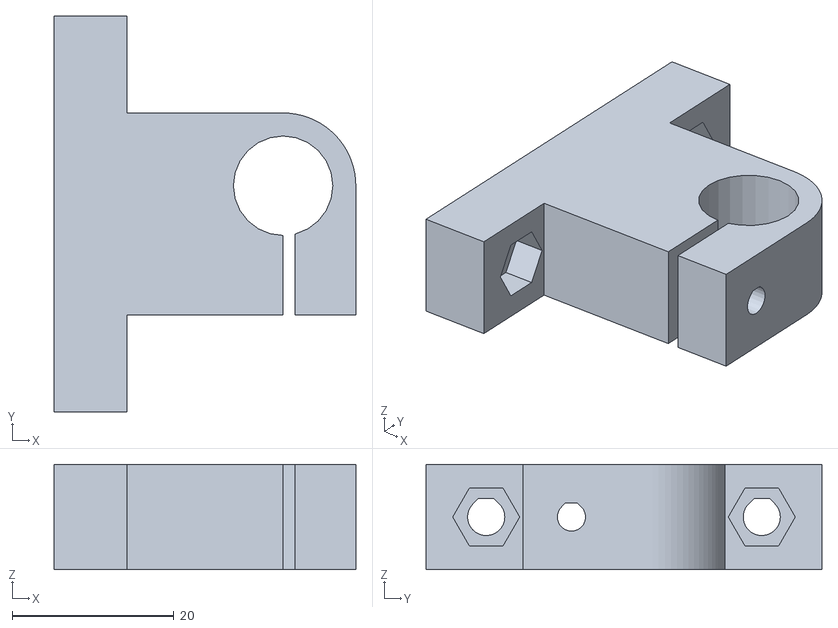
[picture p57: CAD file, 2014-06-18]
val/stls/y_bar_clamp.stl
37.3 x 49.0 x 13.0
