talbo/Mendel90VAL/val/stls/d_motor_bracket_lid.stl

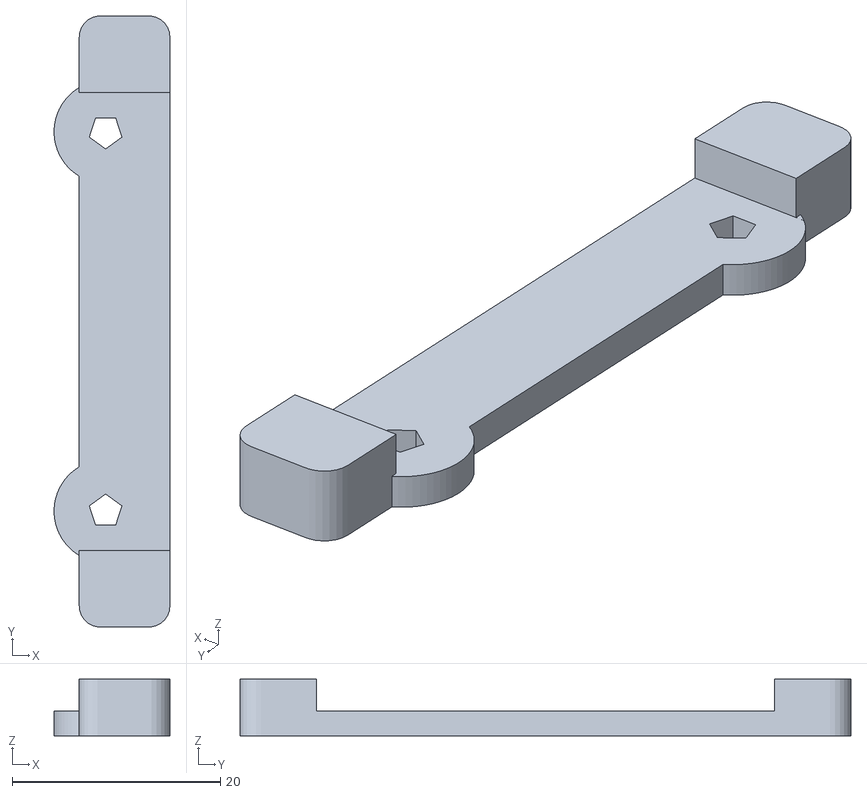
[picture p58: CAD file, 2014-06-18]
val/stls/d_motor_bracket_lid.stl
11.1 x 58.6 x 5.45
