talbo/Mendel90VAL/val/stls/atx_long_bracket.stl

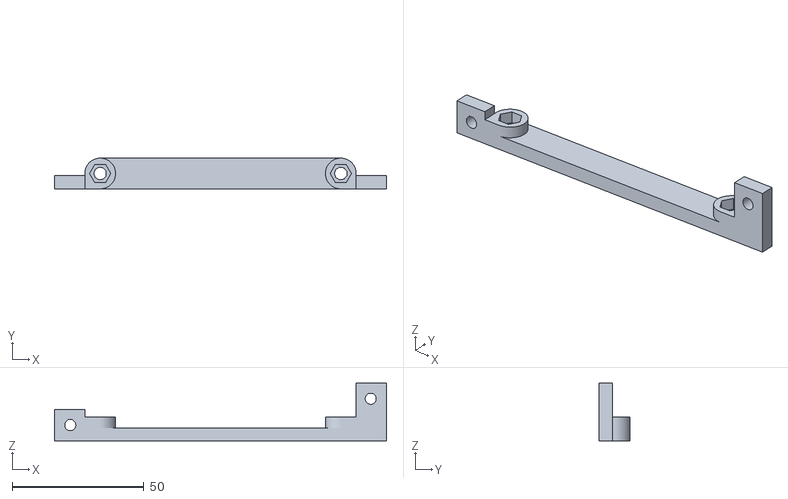
[picture p59: CAD file, 2014-06-18]
val/stls/atx_long_bracket.stl
126.0 x 11.7 x 22.0
