talbo/Mendel90VAL/val/stls/x_belt_clamp.stl

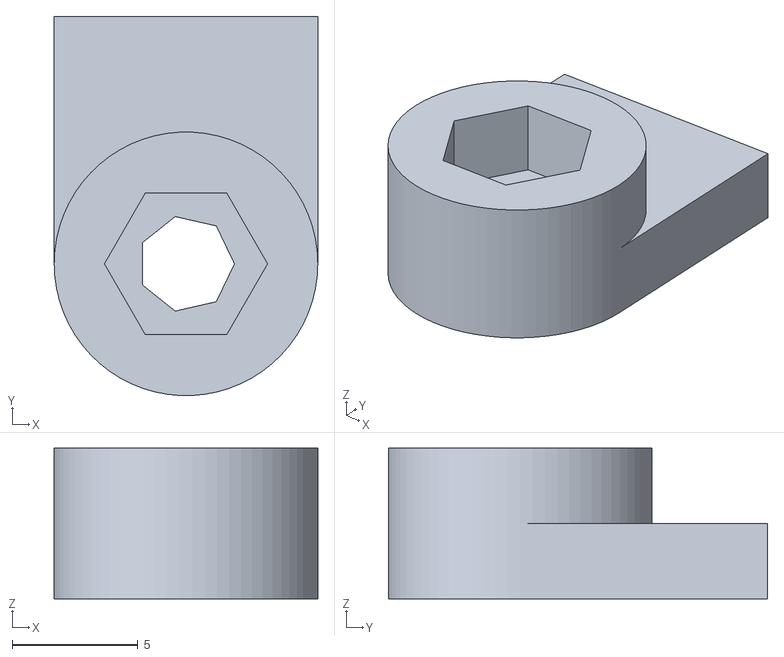
[picture p60: CAD file, 2014-06-18]
val/stls/x_belt_clamp.stl
10.5 x 15.1 x 6.00
