talbo/Mendel90VAL/val/stls/ribbon_clamp_26_44N.stl

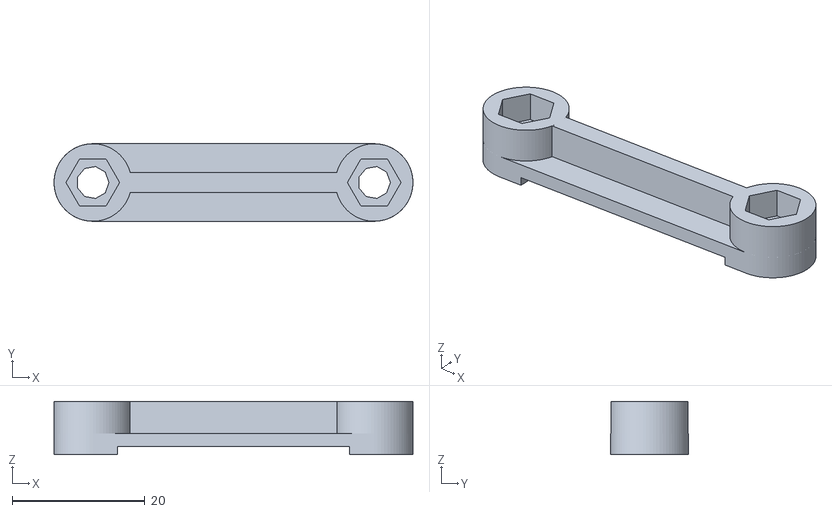
[picture p61: CAD file, 2014-06-18]
val/stls/ribbon_clamp_26_44N.stl
54.1 x 11.7 x 8.01
