talbo/Mendel90VAL/val/stls/d_shell_lid.stl

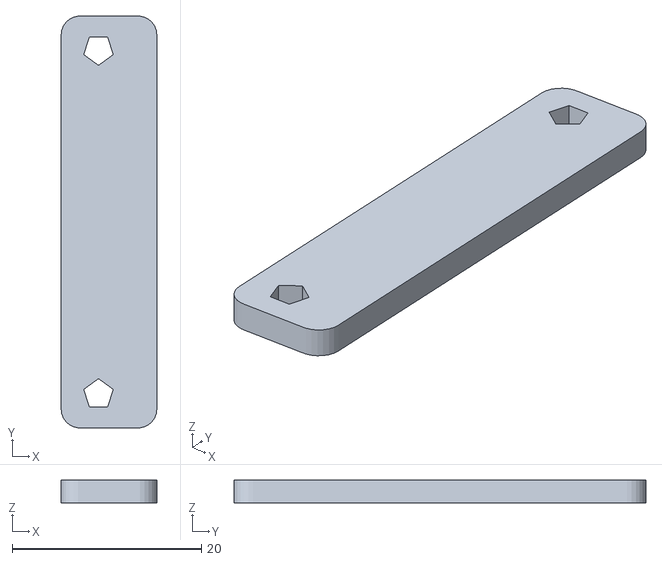
[picture p62: CAD file, 2014-06-18]
val/stls/d_shell_lid.stl
10.1 x 43.5 x 2.40
