talbo/Mendel90VAL/val/stls/x_carriage_fan_bracket.stl

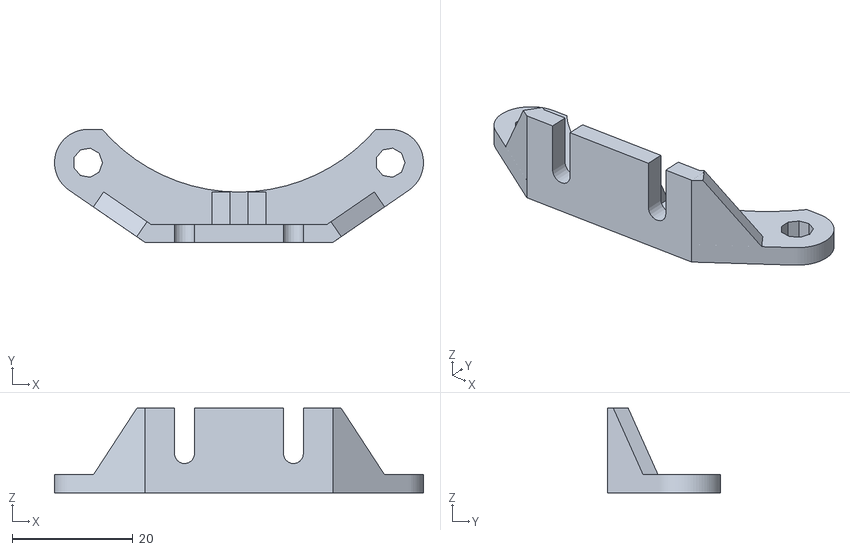
[picture p63: CAD file, 2014-06-18]
val/stls/x_carriage_fan_bracket.stl
61.0 x 18.7 x 14.0
