talbo/Mendel90VAL/val/stls/x_carriage.stl

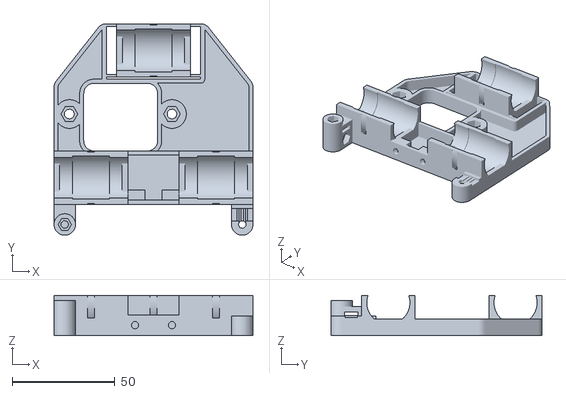
[picture p64: CAD file, 2014-06-18]
val/stls/x_carriage.stl
97.0 x 103.1 x 19.5
