talbo/Mendel90VAL/val/stls/wades_idler_block.stl

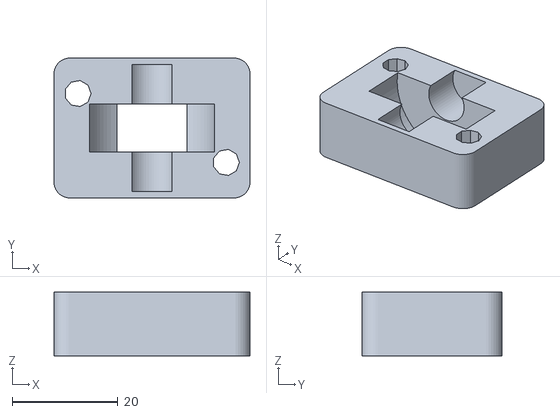
[picture p65: CAD file, 2014-06-18]
val/stls/wades_idler_block.stl
37.0 x 26.4 x 12.0
