talbo/Mendel90VAL/val/stls/ribbon_clamp_14_33NB.stl

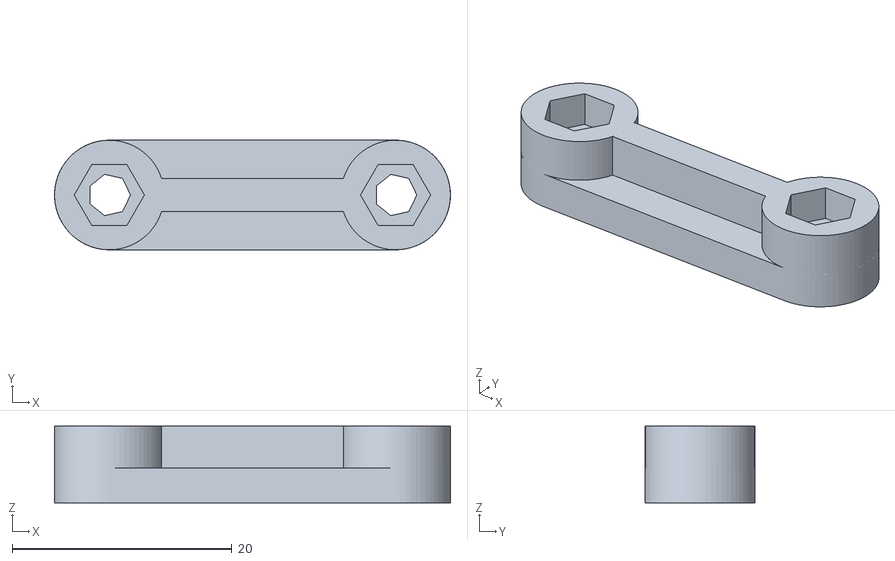
[picture p66: CAD file, 2014-06-18]
val/stls/ribbon_clamp_14_33NB.stl
36.1 x 10.00 x 7.01
