talbo/Mendel90VAL/val/stls/wades_gear_spacer.stl

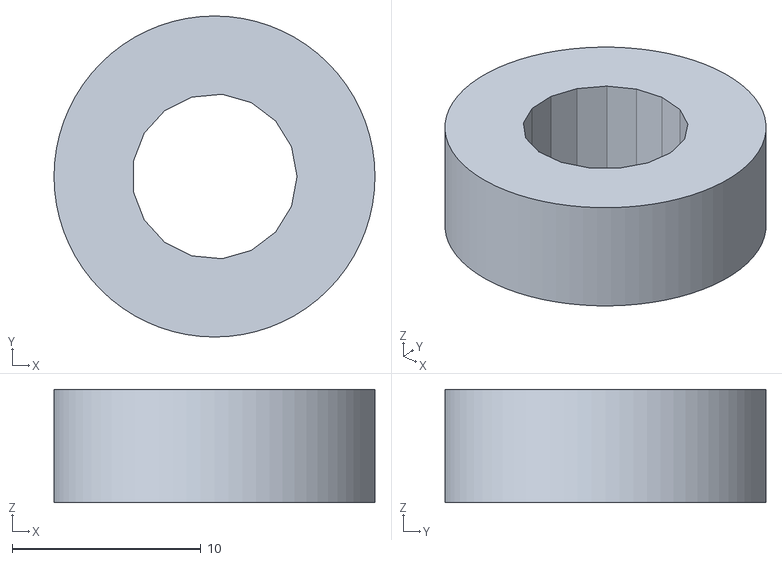
[picture p67: CAD file, 2014-06-18]
val/stls/wades_gear_spacer.stl
17.0 x 17.0 x 6.00
