talbo/Mendel90VAL/val/stls/wades_block.stl

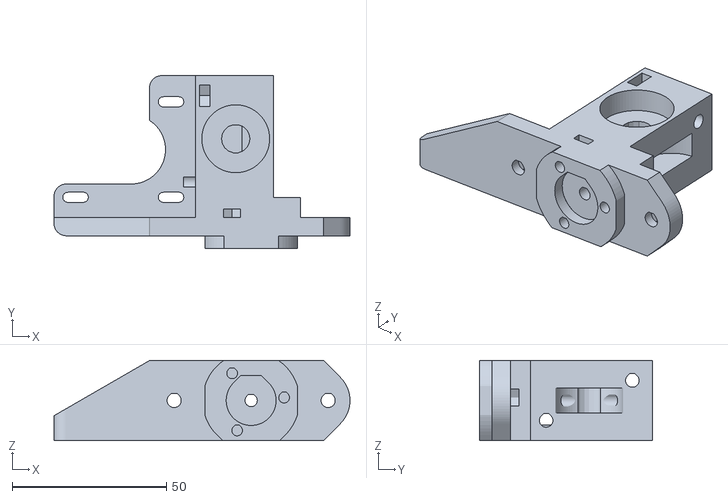
[picture p68: CAD file, 2014-06-18]
val/stls/wades_block.stl
96.1 x 56.1 x 26.0
