talbo/Mendel90VAL/val/stls/z_bar_clamp.stl

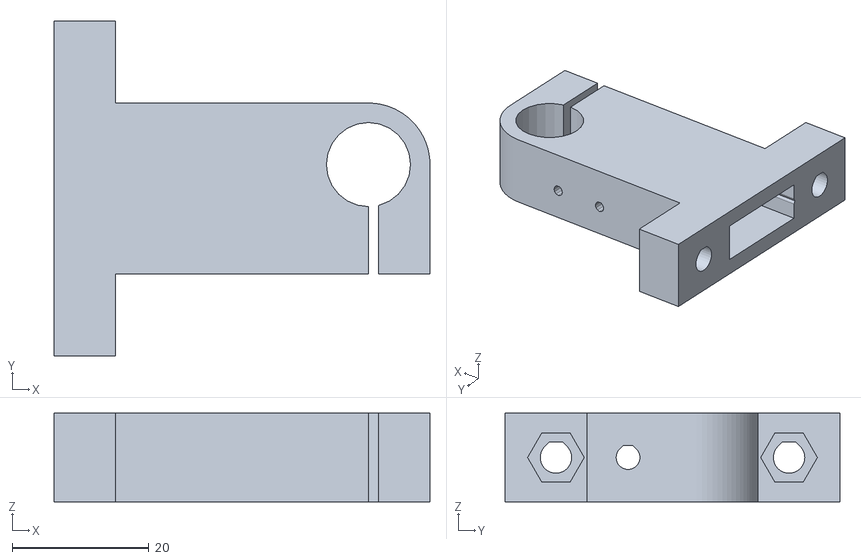
[picture p69: CAD file, 2014-06-18]
val/stls/z_bar_clamp.stl
55.0 x 49.0 x 13.0
