talbo/Mendel90VAL/(list of files, cad)

Other CAD files:
val/stls/z_motor_bracket_lhs.stl
val/stls/fixing_block.stl
val/sheets/frame_base_dxf.scad
val/sheets/frame_gantry_and_y_carriage_dxf.scad
val/sheets/frame_gantry_dxf.scad
val/sheets/frame_left_dxf.scad
val/sheets/frame_right_dxf.scad
val/sheets/frame_stays_dxf.scad
val/sheets/y_carriage_dxf.scad
val/sheets/y_heatshield_dxf.scad
val/stls/z_screw_pointer.stl
