talbo/Mendel90VAL/val/sheets/frame_base.pdf

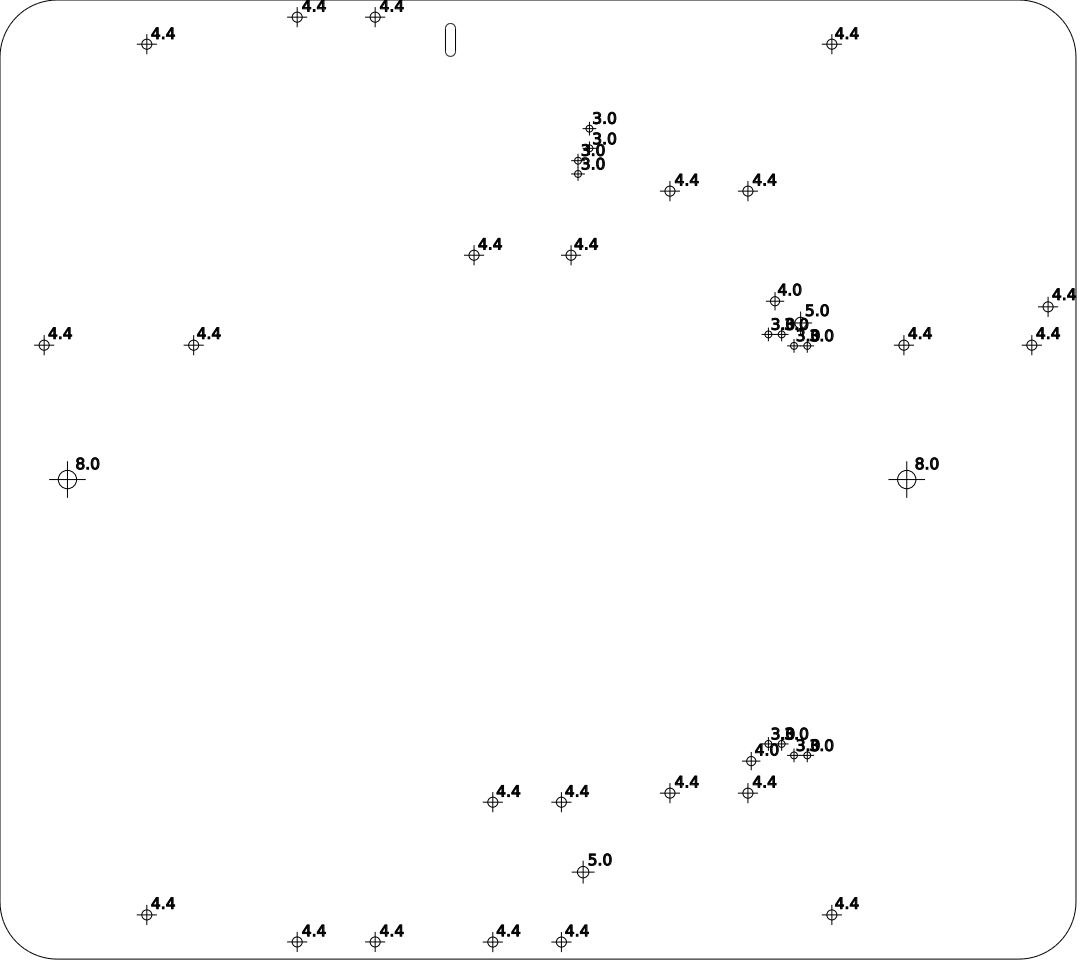
[picture p71: page 1]
