talbo/Mendel90VAL/val/sheets/frame_gantry.pdf

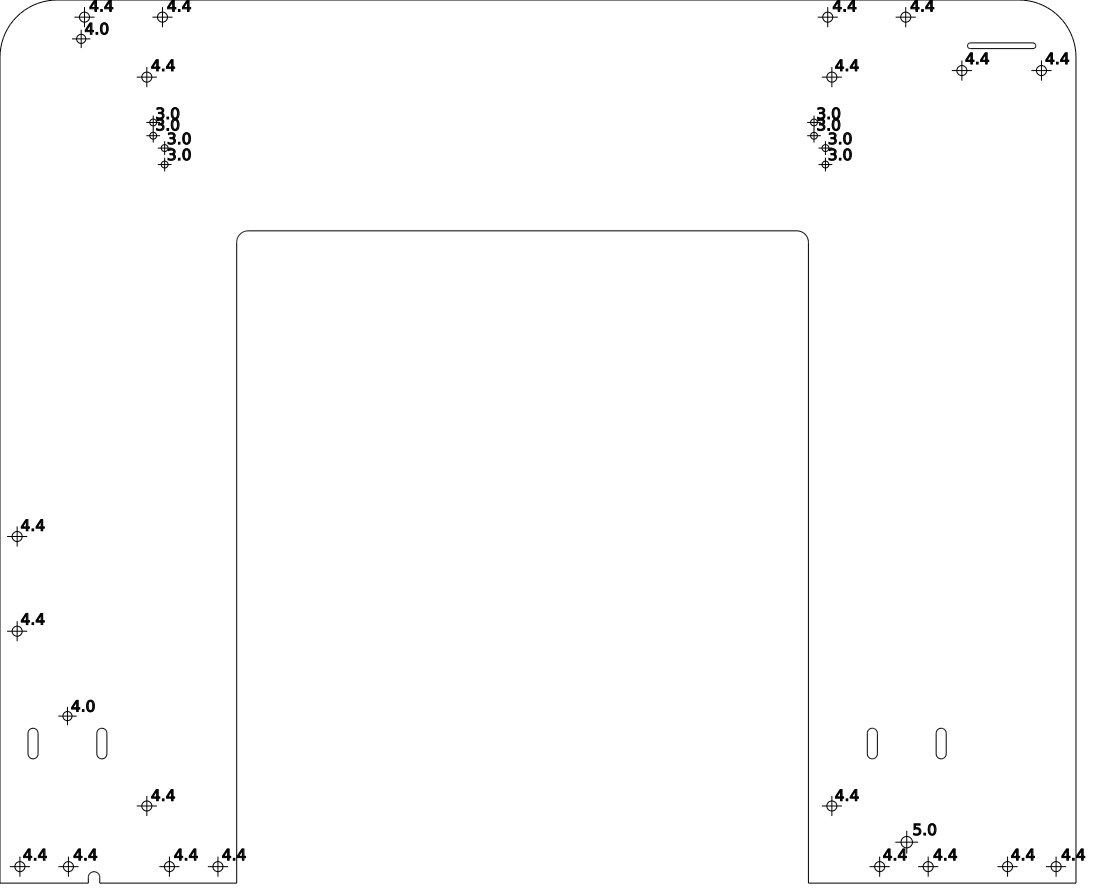
[picture p72: page 1]
