talbo/Mendel90VAL/val/sheets/frame_gantry_and_y_carriage.pdf

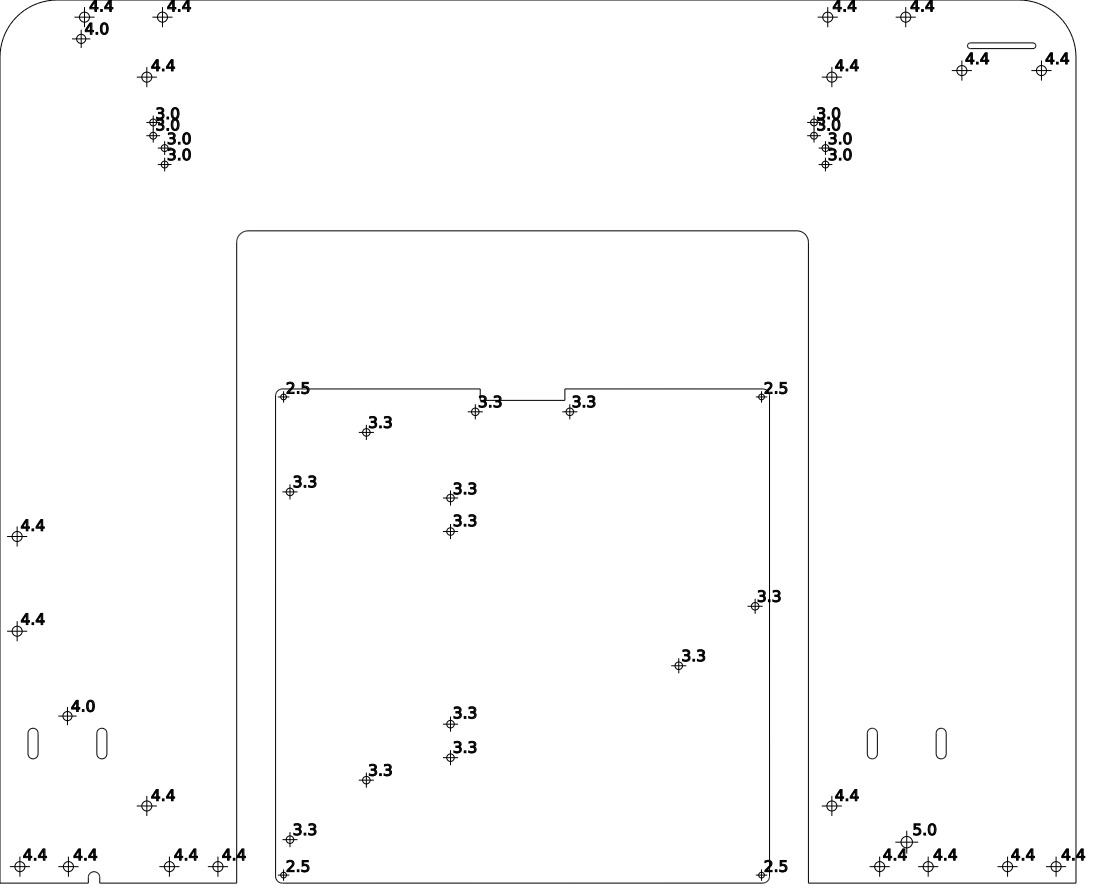
[picture p73: page 1]
