talbo/Mendel90VAL/val/sheets/frame_left.pdf

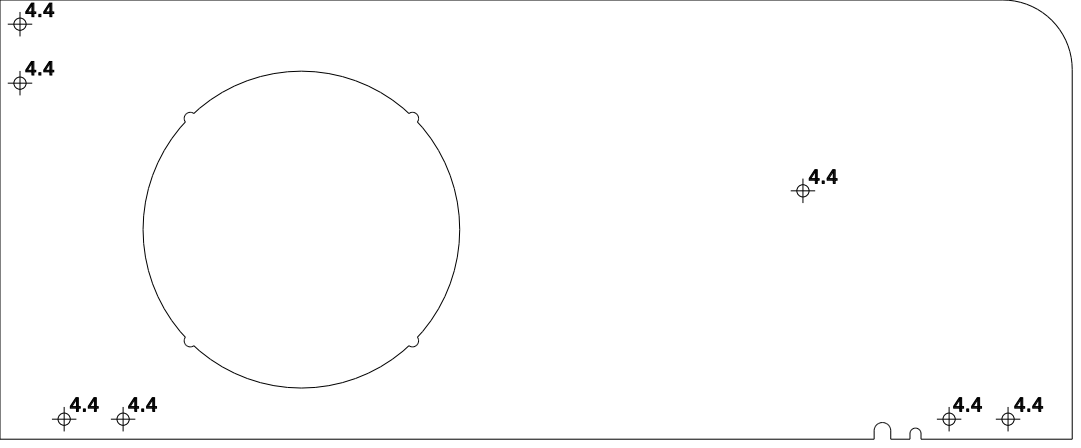
[picture p74: page 1]
