talbo/Mendel90VAL/val/sheets/frame_right.pdf

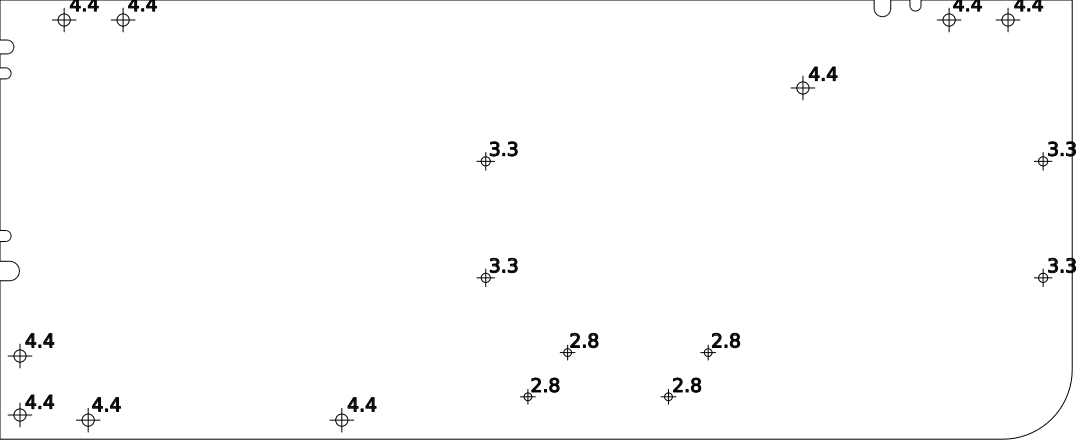
[picture p75: page 1]
