talbo/Mendel90VAL/val/sheets/frame_stays.pdf

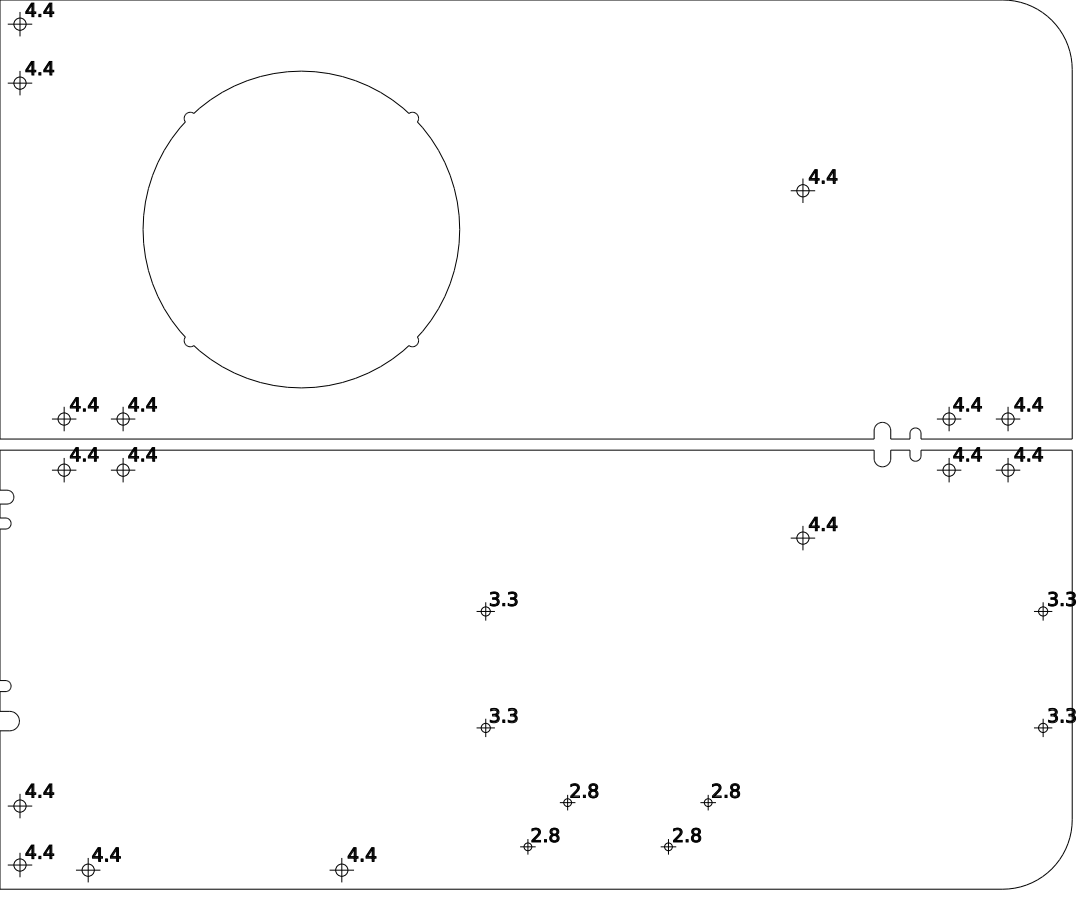
[picture p76: page 1]
