talbo/Mendel90VAL/val/sheets/y_carriage.pdf

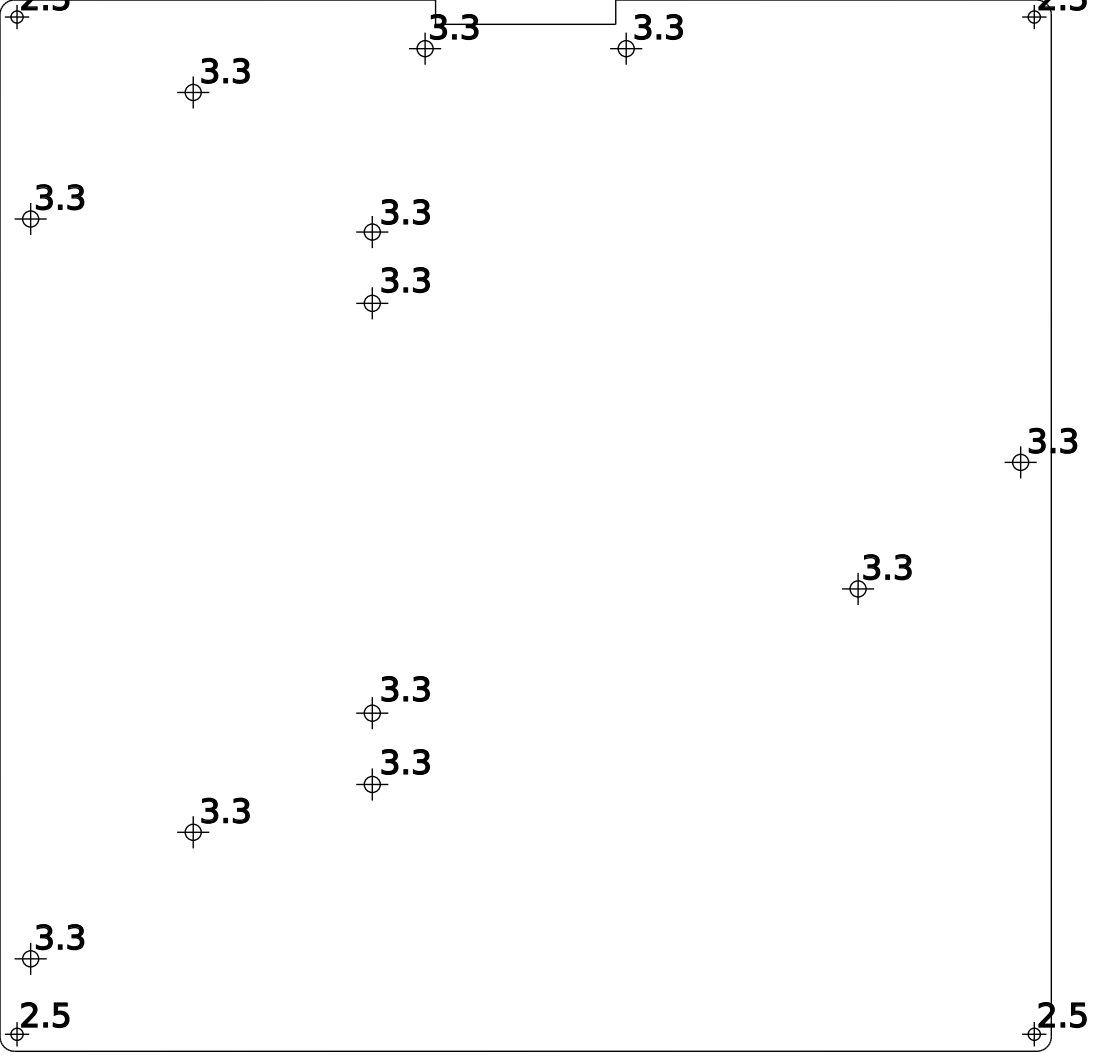
[picture p77: page 1]
