talbo/Mendel90VAL/val/bom/extruder_connection_pcb_assembly.txt

extruder_connection_pcb_assembly:
Vitamins:
  1 15 way D PCB mount plug
  1 2 way Molex KK header
  1 3 way Molex KK header
  1 Extruder connection PCB
  2 4 way terminal block

Printed:
