talbo/Mendel90VAL/val/bom/extruder_motor_assembly.txt

extruder_motor_assembly:
Vitamins:
  2 M3 cap screw x 45mm
  1 M3 grub screw x 6mm
  1 NEMA17 x 47mm stepper motor
  3 Nut M3
  2 No2 pan wood screw x 13mm
  2 Washer M2.5 x 5.9mm x 0.5mm
  2 Washer M3 x 7mm x 0.5mm

Printed:
  1 d_motor_bracket.stl
  1 d_motor_bracket_lid.stl
  1 wades_small_gear.stl

Sub-assemblies:
  1 extruder_connection_pcb_assembly
