talbo/Mendel90VAL/val/bom/frame_assembly.txt

frame_assembly:
Vitamins:
  2 Acrylic sheet 158mm x 386mm x 5mm
  1 Acrylic sheet 471mm x 386mm x 5mm
  1 Acrylic sheet 471mm x 419mm x 5mm
 34 M4 cap screw x 16mm
 36 Nyloc nut M4
  2 AL square tube 12.7 x 12.7 x 1.63 x 400mm
 38 Washer M4 x 9mm x 0.8mm
 10 Ziptie 100mm min length

Printed:
  8 fixing_block.stl
  2 rear_fixing_block.stl
  1 ribbon_clamp_20_44N.stl
  1 ribbon_clamp_26_44N.stl
  4 tube_cap.stl
