talbo/Mendel90VAL/val/bom/x_axis_assembly.txt

x_axis_assembly:
Vitamins:
  1 Belt T2 x 6mm x 872mm
  2 Smooth rod 12mm x 387mm
  2 Wingnut M4

Printed:

Sub-assemblies:
  1 extruder_assembly
  1 x_carriage_assembly
  1 x_carriage_fan_assembly
