talbo/Mendel90VAL/val/bom/z_axis_assembly.txt

z_axis_assembly:
Vitamins:
  2 M3 cap screw x 20mm
  4 M4 cap screw x 16mm
  2 Brass nut M6
  2 Nyloc nut M3
  4 Nyloc nut M4
  2 No2 pan wood screw x 13mm
  2 Smooth rod 12mm x 338mm
  1 Microswitch
  2 Threaded rod M6 x 298mm
  2 Washer M2.5 x 5.9mm x 0.5mm
  2 Washer M3 x 7mm x 0.5mm
  4 Washer M4 x 9mm x 0.8mm

Printed:
  2 z_bar_clamp.stl
  2 z_screw_pointer.stl

Sub-assemblies:
  1 x_idler_assembly
  1 x_motor_assembly
  1 z_limit_switch_assembly
  2 z_motor_assemblies
