talbo/Mendel90VAL/val/bom/z_limit_switch_assembly.txt

z_limit_switch_assembly:
Vitamins:
  2 M4 cap screw x 16mm
  1 M3 hex screw x 16mm
  1 Nyloc nut M3
  2 Nyloc nut M4
  2 No2 pan wood screw x 13mm
  1 Microswitch
  2 Washer M2.5 x 5.9mm x 0.5mm
  1 Washer M3 x 7mm x 0.5mm
  2 Washer M4 x 9mm x 0.8mm
  2 Rubber washer M3 x 10mm x 1.5mm

Printed:
  1 z_limit_switch_bracket.stl
